yuzukq/hikyaku/docs/README.md

# hikyaku ドキュメント

| 文書 | 内容 |
|---|---|
| [hardware/parts.md](hardware/parts.md) | 部品表と手持ちの状況 |
| [hardware/pcb.md](hardware/pcb.md) | **PCB 化（回路図・フットプリント・発注前の確認）** |
| [hardware/assembly.md](hardware/assembly.md) | 組み立て（ユニバーサル基板・完成形の配線） |
| [hardware/wiring.md](hardware/wiring.md) | 配線（S3 SuperMini のピン配置・ピン割り当て・書き換え手順） |
| [hardware/power.md](hardware/power.md) | 電源（CH9102F から給電・モバイルバッテリー。不要になった Type-C DIP 化キットの記録） |
| [hardware/usb-serial-ch9102f.md](hardware/usb-serial-ch9102f.md) | USB-シリアル変換（ログ用）の使い方 |
| [hardware/trackpad-tm035035.md](hardware/trackpad-tm035035.md) | トラックパッド TM035035 の仕様メモ |
| [keyboard-7skb.md](keyboard-7skb.md) | 対象キーボード 7skb の USB/HID 構成 |
| [ota.md](ota.md) | OTA（BLE 経由のファーム更新）の使い方と仕組み |
| [handoff.md](handoff.md) | 引き継ぎメモ（現状・作業のルール・やってほしいこと） |
| [firmware.md](firmware.md) | ファームウェアの構成・ビルド・書き込み・デバッグ・落とし穴 |
| [design/multi-host.md](design/multi-host.md) | 2 台のマシン（Mac・Windows）の切り替えと、Windows アプリの技術選定 |
| [../win/README.md](../win/README.md) | Windows アプリ（C# / WPF）のビルドと試し方 |
| [design/ring.md](design/ring.md) | ショートカットリング（Mac アプリ `mac/HikyakuRing`）の仕様と使い方 |
| [reference/datasheets.md](reference/datasheets.md) | データシート等へのリンクと保管場所 |

進捗と今後の計画は [../ROADMAP.md](../ROADMAP.md)、全体像は [../README.md](../README.md)。
