yuzukq/hikyaku/tools/traces/README.md

# 実機ログ（トラックパッド）

CH9102F 経由（`tools/hk log`）または S3 の USB-C から直接（`tools/hk usb-log`）取った S3 のログ。色コードと、接続相手のアドレス行は取り除いてある。

| ファイル | 中身 | 注意 |
|---|---|---|
| `2026-10-13-relative-all.log` | 相対モード（`trackpad-trace`）の一晩分。`rel <ms> raw=[b0, b1, b2] dx= dy=` が 1 パケット 1 行。`selftest mode=...` の読み戻しテストの結果も含む | **ほとんどがメス-メスのジャンパー線で接触が不安定だった時期のもの。** `raw=[fc, fc, fc]`（dx=-4 dy=-4）は配線が外れているときのゴミ。`firmware id=0xfc` や `0x00` で始まった起動の区間は信用しない。正常に起動した区間（`firmware id=0x07`、末尾）は、ほぼ動きがない |
| `2026-10-13-absolute-sweep.log` | 旧方式（絶対座標）の `tp <ms> <x> <y> <z> khz=<SPI周波数> raw=[...]`。SPI の周波数を切り替えながら取ったもの | 1MHz 以下では上位ビットが化ける（2MHz 以上が正しい）。これを読むコード（`examples/replay.rs`）は削除済み。タグ `absolute-mode-last` に残っている |
| `2026-10-15-board-sens2x.log` | 基板化後・感度 2X で円を約 20 秒描いたもの（`usb-log` で取得）。1,041 パケット、取りこぼし 0 | 正常な状態のログ。左右・上下とも出ている |

起動の区切りは `ESP-ROM` / `rst:0x` の行。区間ごとの内訳（正常なパケット / `fc` のゴミ）は次のコマンドで出せる。

```sh
awk '/ESP-ROM|rst:0x/{b++} /rel [0-9]+ raw=/{ if ($0 ~ /fc, fc, fc/) fc[b]++; else ok[b]++ }
     END { for (i in ok) print "boot", i, "ok", ok[i], "fc", fc[i] }' tools/traces/2026-10-13-relative-all.log
```

## ホストで再生する

相対モードの変換（軸の入れ替え・反転・倍率・持ち越し・レポートの分割）は `crates/hikyaku-pointer/src/relative.rs` にあり、
ファームと同じ処理をホストで再生できる。

```sh
# 1 パケットごとに出るマウスレポートと集計を見る（quiet=1 で集計だけ。skip_fc=1 で配線不良のゴミを読み飛ばす）
cargo run -q -p hikyaku-pointer --example replay_rel -- tools/traces/2026-10-13-relative-all.log quiet=1 skip_fc=1
# 設定を変えて試す（既定はファームの値: gain=2 swap=1 invx=1 invy=1 scroll_div=8）
cargo run -q -p hikyaku-pointer --example replay_rel -- tools/traces/2026-10-13-relative-all.log gain=1
```

`cargo test -p hikyaku-pointer` は、このログ全体と乱数のパケットで、切り出した処理がファームの元のコード（テスト内の `Golden`）と
1 ビットも違わない出力を出すことを確かめる。
