yuzukq/hikyaku/docs/hardware/trackpad-tm035035.md

# トラックパッド TM035035（Cirque GlidePoint 円形）

出典: *TM035035 Trackpad Specification* Document Version 1.2（2017-11）。
**この仕様書は Cirque の機密表記つきでリポジトリに入れていない**（保管場所は [../reference/datasheets.md](../reference/datasheets.md)）。以下は要点のメモ。

## 型番

| 種別 | 型番 |
|---|---|
| I²C | TM035035-2023-xxx |
| **SPI（手元はこちら）** | TM035035-2024-xxx（x は末尾でオーバーレイの種類: 000 なし / 001 粘着 / 002 フラット / 003 曲面） |

SPI/I²C の切り替えは基板上の **R1**：470kΩ 実装 = SPI、未実装 = I²C。

## 電気的仕様

| 項目 | 値 |
|---|---|
| 電源 | 2.5〜3.6V（3.3V で試験） |
| 消費電流 | 動作時 2.9mA / アイドル 1.7mA / スリープ 40µA（設定要）/ シャットダウン 0.23µA（設定要） |
| ロジックレベル | 3.3V（**GPIO は 5V 耐性なし**） |
| ASIC | Cirque Pinnacle (1CA027) |

## J1 コネクタ（12 ピン FFC, SPI）

Molex 78127-1128 相当（12 回路, 0.5mm ピッチ, 縦型, **非 ZIF**, リバースフットプリント）。
FFC は「**導体が見える面を 1 ピン側**にして挿す」。

| 1 | 2 | 3 | 4 | 5 | 6 | 7 | 8 | 9 | 10 | 11 | 12 |
|---|---|---|---|---|---|---|---|---|---|---|---|
| SCK | MISO | SS | DR | MOSI | BTN2 | BTN3 | BTN1 | SCL | SDA | GND | VDD 3.3V |

- DR = Data Ready（タッチデータがあるとき出力）。ポーリングでも読める
- BTN1〜3 は物理ボタン入力（使わなければ未接続）
- SCL/SDA は SPI 版では使わない

## 座標

- 最大範囲: X 0〜2048, Y 0〜1536
- 実用範囲（クリップ推奨）: **X 128〜1920, Y 64〜1472**
- 座標系: 原点は左上、X は右が +、Y は下が +。ただし **Y 軸はデフォルトで反転**しており、FeedConfig1 の bit7 で反転できる
- 位置は相対（デルタ）／絶対のどちらでも報告できる。モードは電源投入時にホストが設定する

## 寸法

直径 35mm、センサー有効径 31mm。厚さ: 基板 1.0mm、基板＋オーバーレイ 1.25mm、部品込み 5.40mm。
外周に位置合わせ用の切り欠きが 3 つ。ケースでは下から支える（タップでたわむのを防ぐ）。導電性の素材をベゼルに使わない。
オーバーレイは導電性の素材（金・銀・カーボン等）NG、基板との間に空気層を作らない。

## ソフトウェア側

- **ドライバ:** `crates/hikyaku-pinnacle`。SPI（モード 1、2MHz）の RAP: 書き込み `[0x80|addr, v]`、読み出し `[0xA0|addr, 0xFC, 0xFC, 0xFC…]` で **4 バイト目以降**がデータ（自動インクリメント）。
  相対モードだけを扱う（初期化の手順は下の「実装の方針」）。実機で ID=0x07 / バージョン=0x3A を確認済み。
- **変換:** `crates/hikyaku-pointer` の `relative`（相対モードのパケット → マウスレポート）。
- 絶対座標モード（FeedConfig1=0x03、パケットはレジスタ 0x12〜0x17）で自前に移動量を作る旧方式は 2026-10-13 に削除した（タグ `absolute-mode-last`）。
- 参考実装: QMK `cirque_pinnacle`、https://github.com/2bndy5/CirquePinnacle
- **単一指のみ**（Pinnacle 1CA027 は 1 本指の位置しか報告しないと理解している。要確認）。
  ROADMAP にあった「2 本指スクロール」は難しいので、キー押下中スクロール／縁での円スクロールなどで代替する想定。

## 実装の方針（2026-10-13〜）

ZMK（Zephyr の `drivers/input/input_pinnacle.c`）と Cirque 公式の USB マウスのサンプル
（`cirque-corp/Cirque_Pinnacle_1CA027` の `SPI_FlatOverlay_USBMouse.ino`）に合わせた。

- **相対モード**で、パッドが計算した移動量を **1:1 でそのまま**マウスレポートにする（加速は OS に任せる）。
  丸いパッドを長方形の画面に対応づける絶対座標の方式はやめた。
- 初期化: ソフトリセット → 電源投入時のキャリブレーション完了（SW_CC）を待つ → 感度（ADC 減衰 2X。4X では指の検出が途切れた）→ キャリブレーション
  → `FeedConfig2 = 0x1C`（GlideExtend・スクロール・二次タップ無効。タップ有効）→ `FeedConfig1 = 0x01`（相対 + 有効）→ ZIdle = 0。
  **パッド側の反転ビット（0x40/0x80）は使わない**: 相対モードで Y 反転を入れると Y の移動量がほとんど出なくなった（2026-10-13）。
  向きはファーム側（`SWAP_XY`・`SCREEN_X_INVERT`・`SCREEN_Y_INVERT`）で合わせる。この個体はパッドが 90 度回った向きで付いている。
- パケットは 3 バイト。`dx = b1 (b0 の bit4 が立っていたら -256)`、`dy` も同様（bit5）。タップは `b0` の bit0。
- 向き・反転・XY 入れ替えは `firmware/hikyaku-s3/src/bin/trackpad/mod.rs` の `SWAP_XY`・`SCREEN_*_INVERT`。
- 変換そのもの（向き・倍率・持ち越し・レポートの分割）は `crates/hikyaku-pointer/src/relative.rs`（`Relay`）。ホストで実機ログを
  再生してテストできる（[../../tools/traces/README.md](../../tools/traces/README.md)）。静止中のぶれを抑えるフィルタ（`StillFilter`）と
  自前のタップ判定（`SoftTap`）も同じファイルにあり、ファームでは `trackpad-still-filter` / `trackpad-soft-tap` feature で有効にする
  （既定は無効。[../firmware.md](../firmware.md) の feature 一覧）。

- **SPI のクロックは 2MHz 以上にすること。** 250kHz〜1MHz だと、パッドから読む値の MSB が取り違えられる（レジスタの読み戻しテストで約半分が誤り。`0xFF`→`0x7F`、`0x5A`→`0xDA` など）。2MHz・4MHz は 0 エラー（2026-10-13）。
  これを知らずに低いクロックで動かしたため、座標が飛ぶ・片寄るなど、長い間うまく動かなかった。QMK の既定クロックは数 MHz〜10MHz。
- 初期化は QMK と同じ手順（リセット → ADC 減衰 → キャリブレーション）を踏む。起動中（約 1 秒）はパッドに触れない。

- 2026-10-11: ESP32-S3 に SPI で接続（GPIO12=SCK / 13=MISO / 11=MOSI / 10=SS / 9=DR, 3V3, GND。モード 1, 1MHz）。起動ログ `trackpad: firmware id=0x07 version=0x3a` を確認。
  ドライバの SPI コマンド形式（読み出しは 4 バイト目からデータ）が合っていた。
- 接続は FFC 12P ケーブル + 変換基板（ブレッドボード）。

## 実機で確認・調整すること

- Y 軸の向き（`Config::invert_y`）
- ゲイン・加速・平滑化・タップ判定の閾値の体感調整

## 未決

- 実際に使う接続手段（FFC ケーブル + 変換基板か、パッドへの直接はんだ付けか）
- タップ／ドラッグ／スクロールの仕様
