yuzukq/hikyaku/ROADMAP.md

# ROADMAP

詳しい資料は [docs/](docs/README.md) を参照。

## Phase 0: 部品調達

- [x] ESP32-S3 ボード（C3 は USB ホスト不可と判明し、S3 を再調達。2026-10-08 到着。**XIAO ではなく GPIO 番号印字のボード**。ESP32-S3FH4R2 搭載）
- [x] Cirque TM035035（SPI 版 `-2024`）
- [x] USB-C ⇔ USB-C ケーブル（CC の問題なく動作確認済み）
- [x] 秋月 AE-CH9102F-TYPEC-BO（USB-シリアル変換）… ホスト動作中のログ確認用
- [x] 秋月 AE-USB2.0-TYPE-C-5077CR（Type-C DIP 化キット）… 電源用。**CC に 5.1kΩ ×2 が必要**（[docs/hardware/power.md](docs/hardware/power.md)）
- [x] モバイルバッテリー（Type-C 出力の小型品）、ブレッドボード、ジャンパ類
- [x] 開発用の給電・ログを CH9102F に切り替え（C3 は不要に。2026-10-09 確認）
- [x] ~~5.1kΩ ×2~~（CH9102F から給電することにしたので不要）
- [x] トラックパッド用の FFC ケーブル 12P 0.5mm + 変換基板

## Phase 1: USB ホストでキーボードを読む ✅

- [x] 開発環境: **Rust（esp-hal + esp-rtos + embassy + trouble）**
- [x] S3 の 5V ピンから給電し、C-C ケーブルでキーボード（7skb）を接続
- [x] USB ホストでキーボードを認識してブートプロトコル入力を読む

## Phase 2: BLE HID キーボードとして Mac につなぐ ✅

- [x] 固定記述子（キーボード / マウス / コンシューマ）の BLE HID
- [x] Linux (BlueZ) と Mac でペアリング・入力を確認
- [x] ボンディング情報をフラッシュに保存（再起動後も自動再接続）

## Phase 3: パススルー（MVP） ✅

- [x] S3 単独で USB キーボード → BLE → Mac を中継（通常キー、同時押し、Mac のショートカット）
- [ ] 遅延・取りこぼしの体感確認（今のところ問題の報告なし）

## Phase 4: トラックパッド統合 ✅（v1、2026-10-15）

- [x] FFC 12P ケーブル + 変換基板でブレッドボードに引き込み（[docs/hardware/trackpad-tm035035.md](docs/hardware/trackpad-tm035035.md)）
- [x] Pinnacle の SPI ドライバ `crates/hikyaku-pinnacle`（SPI モックで単体テスト済み。実機で動作）
- [x] S3 ファームへ組み込み（`--features trackpad`）
- [x] 実機で疎通確認（2026-10-11）: SPI モード 1 / 1MHz、`trackpad: firmware id=0x07 version=0x3a`（参考実装の値と一致）
- [x] **相対モード**に一本化（絶対座標の方式は削除。タグ `absolute-mode-last`）。SPI は 2MHz（1MHz 以下は MSB が化ける）
- [x] 相対モードの変換をホストでテストできる形に切り出し、実機ログを再生できるようにした（2026-10-13 夜、クラウド。`crates/hikyaku-pointer/src/relative.rs`。PR #1）
- [x] 向き（90° 回転を XY 入れ替え + 反転で補正）・速度（`REL_GAIN = 2`。2026-10-22 に 1.8 倍へ少し遅くした）を実機で調整
- [x] タッチ感度を **2X** に（4X では指の検出が途切れた。2026-10-15。動き・タップとも良好）
- [x] 状態表示: オンボードの RGB LED（GPIO48）で 赤 = キャリブレーション中（触らない）/ 緑・青 = 準備完了（送り先 1・2）/ 赤の点滅 = パッドが見つからない
- [ ] （任意）静止中のぶれを抑えるフィルタ `trackpad-still-filter`、自前のタップ判定 `trackpad-soft-tap` を実機で試す（既定は無効。今のところ不要）
- [x] **スクロール**（2026-10-20）: キーボードの **F24 を押している間**、パッドの上下の動きを縦スクロールにする（F24 は Mac に送らない）。7sPro では親指キーの長押し（QMK のモッドタップ）に F24 を割り当てる。
  向きは持ち主の Mac に合わせて反転（`SCROLL_INVERT`）。速さはパッドの移動量 18 で 1 目盛り（2026-10-22 に 8 → 10 → 12 → 14 → 16 → 18 と減らした）。カーソルは 1.8 倍。**どちらも良好で、これを既定とする（2026-10-22）。**
  2 本指スクロールは不可と判断: 2 本指で触っても、パッドは 1 本の指の動きとして報告し、2 本指を示すビットがない（実機ログで確認。2 本指タップもタップにならない）。
- [x] **本体のボタン**（2026-10-22、実機で確認済み）: GPIO6 と GND の間に MX スイッチを 1 個。
  単押し = 右クリック（ダブルタップを待つので約 250ms 遅れる）、押している間 = スクロール（押したまま動かしたらクリックしない）、
  ダブルタップ = リングの開閉（F23 と同じ）。リング中（ノブ操作を含む）は 1 回押しで閉じる（2026-10-22 実機で確認）。キーボードなしでも使えるように。判定は `crates/hikyaku-pointer/src/button.rs`
- [ ] （任意）横スクロール（スクロール中の左右の動きを AC Pan に）、なめらかなスクロール（HID の Resolution Multiplier。Mac の対応を要確認）、縁をなぞる円スクロール（絶対座標が要る。Phase 9 と合わせて検討）
- [x] 別のキーボード（KBDfans TOFU60 / Og60、`4b42:6071`）（2026-10-23 解決。ほぼ全キーで確認。普段用のファーム e280c55 でも確認）: 原因は 2 つ。
  (1) ライブラリの `KbdHandler::try_register` が構成記述子を読み直すところで TOFU60 が返事をしなくなり、登録が終わらなかった →
  認識のときに読んだ構成記述子を使う自前の `open_keyboard` に置き換え、制御転送に時間切れを付けた。
  (2) バスリセットの直後に問い合わせると応答しない → リセット後 100ms 待つ。失敗したら挿し直しを待たずにバスリセットで 3 回までやり直す

## Phase 5: HID の拡充

- [x] メディアキー（音量・輝度など）とマウスの転送（7skb の IF2 → BLE の ID2/ID3）
- [ ] システムコントロール（電源/スリープ）の転送
- [ ] NKRO キーボード対応（7skb は 6KRO で足りている）
- [ ] キーリマップやレイヤー（特定キー押下中はトラックパッドがスクロール、など）

## Phase 6: 電源

- [x] 方針: モバイルバッテリー → **CH9102F の USB-C**（CC 抵抗あり）→ +5V → S3 の 5V ピン（2026-10-13 変更。Type-C DIP 化キットは不要に）
- [x] CH9102F（PC につないだもの）からの給電で、S3・キーボード・トラックパッドが動くことを確認（2026-10-15、基板）
- [x] モバイルバッテリーから 5V が出て、同じように動くことを確認（2026-10-15）
- [ ] 自動オフしないかを実機で確認（S3 + BLE + キーボードで 100mA 前後）
- [ ] スリープ／復帰と実測の電池持ち

## Phase 6.5: 基板化

配線の完成形: [docs/hardware/assembly.md](docs/hardware/assembly.md)

- [x] ピンソケットを調達
- [x] ユニバーサル基板にはんだ付け（SPI は短く、GND 共通。5V の書き込み用ジャンパーは付けず直結にした。書き込み時は CH9102F の USB を抜く）
- [~] 通電前の短絡・導通の確認: テスターがないため、ファームの診断（`trackpad-probe`）で代用。**変換基板がソケットに 180° 逆に挿さっていた**のを見つけて直した（[docs/hardware/assembly.md](docs/hardware/assembly.md)）。テスターは調達したい
- [x] 読み戻しテスト（`selftest`）が 2MHz で 0 エラーになることを確認（2026-10-15）
- [x] CH9102F の受信（RxD）が効かない（ピンソケットを外すときのコテの熱で壊れた可能性）→ 新品に交換して解決（2026-10-21。普段の構成で `tools/hk log` が読める）
- [~] PCB 化: 手配線の取り違え・短絡・接触不良が多かったので、S3・CH9102F・FFC 変換基板をピンソケットで受け、MX スイッチ 2 個（直付け）を載せた基板を作る（[docs/hardware/pcb.md](docs/hardware/pcb.md)）
  - [x] 回路図とフットプリントの割り当て（2026-10-23。持ち主がレビュー中）
  - [ ] レイアウト（持ち主。ケースの設計と合わせる）
  - [ ] 1:1 で印刷して実物のモジュールと合わせる → DRC → ガーバー → 発注
  - [ ] 2 個目のスイッチ（GPIO7）をファームで読む

## Phase 7: 開発体験・筐体

- [~] OTA（BLE 経由のファーム更新）を実装（[docs/ota.md](docs/ota.md)）。**実機では未成立**（PC の接続・購読まで進んだが、書き込みには至らず。2026-10-12 時点で有線書き込みに戻した）。再挑戦するときは docs/ota.md の「状況」を参照
- [ ] 分割キーボードの間に置けるサイズでケースを設計する
- [~] 専用基板（Phase 6.5 の PCB 化）

## Phase 8: 2 台のマシン（Mac・Windows）の切り替え

設計: [docs/design/multi-host.md](docs/design/multi-host.md)。安定性と電力を重視して、**送り先ごとに別の機器（hikyaku / hikyaku2）として 1 台ずつつなぐ**（2026-10-24 決定）。

- [x] ファーム: 送り先 2 つ（アドレス・名前・ペア情報を分ける）、F21 / F22・ボタンの 3 秒長押し・アプリの命令 `23 p` で切り替え（保存して再起動）、
  送り先ごとのスクロールの向き（`22 v`）、Device Information サービス（PnP ID）、LED の色で送り先（緑 / 青）。Mac・Linux で切り替えと再接続を確認（2026-10-24）
- [x] GitHub Actions で Windows アプリをビルドし、Release「windows-latest」に置く
- [x] Windows でペアリングして、キー・マウス・スクロールが動く（2026-10-24。Dell のラップトップの内蔵 Bluetooth、TP-Link のアダプタのデスクトップ）。
  BARROT のアダプタは Windows がサービス全体を発見しないので使えない。TP-Link のアダプタでは、Windows が MTU の交換を 2 回要求して
  ペアリング・接続が切れたので、trouble-host をリポジトリに置いて対処（`firmware/hikyaku-s3/vendor`）。30 秒ごとの切断は Windows の再起動で消えた。
  ボンドごとの購読（CCCD）をフラッシュに保存（再起動・切り替えの後も、Windows に再ペアリングなしでキーが届く）
- [x] Windows: HID として接続中の hikyaku の独自サービスを開ける（`win/RingProbe`・HikyakuRing の接続を確認。2026-10-24）
- [ ] Windows アプリ（C# / WPF、`win/HikyakuRing`）: リング・ノブ・設定画面・アクション
- [ ] Mac アプリ: 送り先の切り替え・スクロールの向きの設定

- [ ] ボンディングのスロット化、ペアリングモードの名前（hikyaku-BLE1/2）
- [x] 状態表示: 準備ができたときの LED の色で送り先を示す（1 台目 = 緑、2 台目 = 青。2026-10-24）
- [ ] トラックパッドのマウスレポートも同じ宛先へ送る
- [ ] Windows での接続確認（Device Information サービスの要否）

## Phase 9: ショートカットリング（Mac アプリ）（仕様決定 2026-10-20）

丸いパッドを活かして、Logi Options+ の Actions Ring のような**円形のショートカットリング**を Mac に出す。
**F23 で起動**し、リング中だけパッドを絶対座標モードにして、指の角度で 8 方向の項目を選び、離した位置で実行する。
音量・明るさ・シークは、離すとノブ操作モードに移り、外周を回して調整する（中心のタップで抜ける）。Mac 側は Swift / SwiftUI のネイティブアプリ。

仕様: [docs/design/ring.md](docs/design/ring.md)

- [x] ファーム: F23 の検出、リングモード（相対 ↔ 絶対座標の切り替え）、独自の BLE サービスで指の角度・距離・接触を notify（2026-10-21。円の中心・半径・向きは実測で合わせた）
- [x] ファーム: アプリからキーの組み合わせ・メディアキーを送る命令（アクセシビリティの許可が不要）
- [x] Linux: Python（bleak）の簡易クライアントでファーム側を確かめる（`tools/ring/ring.sh`）
- [x] Mac: HID として接続中の hikyaku の独自サービスを、アプリから購読できるかの試作（`mac/RingProbe`。**できた**）
- [x] Mac: リングの UI、選択と実行、ノブモード（`mac/HikyakuRing`。2026-10-21）
- [x] Mac: 設定画面、アクション（音量・明るさ・シーク・任意のキーの組み合わせ）
- [x] Mac: 実機で全機能を確認（2026-10-21。7sPro なしでは ⌃⌥R / `hikyaku-ring://open` で開ける）
- [x] **本体の置き方**（2026-10-23。実機で確認済み: 向きの選択・カーソル・スクロール・リングの 8 方向・電源を入れ直しても保持・基準に戻す）: 0° / 90° / 180° / 270°（時計回り）。ファームがカーソル・スクロール・リングの角度を回し、フラッシュに保存。
  Mac アプリの設定画面に「本体の向き」タブ（本体の絵を 4 つの向きで選ぶ）、リングの項目に「設定画面を開く」（標準の割り当てでは左上。Spotlight と入れ替え）。命令 `20 q` / `21`、イベント 4
- [~] Mac: フルスクリーンのアプリの上にもリングを出す（issue #3。2026-10-28 実装、実機で未確認）。リングが見えないまま離した項目は実行しない
- [~] Mac・Windows: リングから設定画面を開いたとき、ほかのアプリの裏にあっても前に出す（issue #2。2026-10-28 実装、実機で未確認）

## 未決事項

- ~~トラックパッドの接続手段~~ → FFC + 変換基板に決定
- ~~スクロール操作の仕様~~ → F24 / 本体のボタンを押している間スクロール（2 本指は不可。Phase 4）
- 複数キーボードやハブ経由の接続に対応するか
- 書き換え手順の改善方法
