yuzukq/hikyaku/docs/reference/datasheets.md

# データシート・参考資料

## 手元に保管しているもの（リポジトリには入れない）

| 資料 | 場所 | 備考 |
|---|---|---|
| TM035035 Trackpad Specification v1.2 (Cirque, 2017-11) | `~/Downloads/TM035035_SPI-I2C-PINNTrackpad_SPEC1-2.pdf` | **Cirque の機密表記あり（複製・開示禁止）。リポジトリにコピーしない**。要点は [trackpad-tm035035.md](../hardware/trackpad-tm035035.md) に自分の言葉でまとめた |

## 公開資料（リンクのみ）

| 資料 | URL |
|---|---|
| 秋月 AE-USB2.0-TYPE-C-5077CR 回路図 | https://akizukidenshi.com/goodsaffix/AE-USB2.0-TYPE-C-5077CR_schematic.pdf |
| 秋月 Type-C DIP 化キット共通資料（電源用途・CC 抵抗） | https://akizukidenshi.com/goodsaffix/powered_by_type-c.pdf |
| 秋月 AE-CH9102F-TYPEC-BO 説明書 (Ver.2024-07-30) | https://akizukidenshi.com/goodsaffix/AE-CH9102F-TYPEC-BO_20240730-web.pdf |
| 秋月 AE-CH9102F-TYPEC-BO 商品ページ | https://akizukidenshi.com/catalog/g/g129505/ |
| esp-hal (Rust) | https://docs.espressif.com/projects/rust/esp-hal/ |
| trouble (BLE host, Rust) | https://github.com/embassy-rs/trouble |
| embassy-usb-host | https://crates.io/crates/embassy-usb-host |
| Cirque Pinnacle ドライバの実装例 | QMK `cirque_pinnacle` / https://github.com/2bndy5/CirquePinnacle |
