yuzukq/hikyaku/3dData/hikyaku4pcb/preview_inside.png

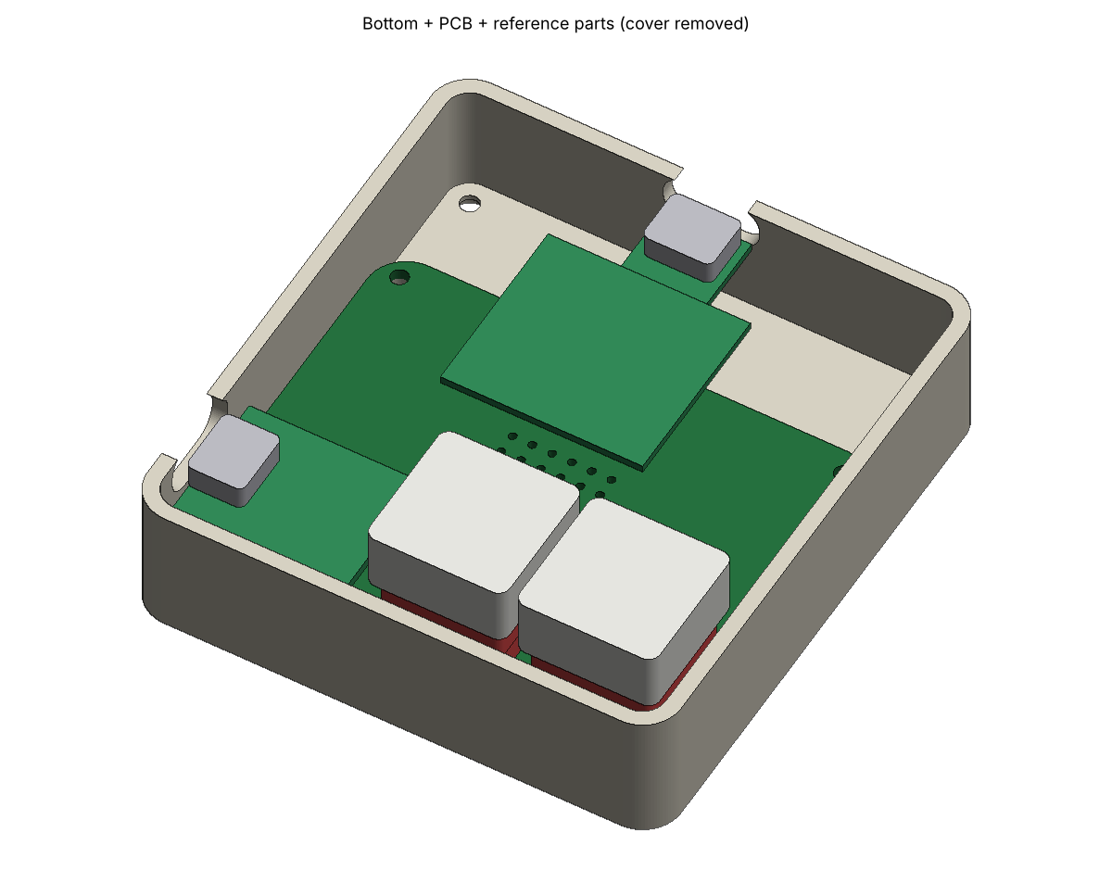
3dData/hikyaku4pcb/preview_inside.png
