yuzukq/hikyaku/3dData/hikyaku4pcb/preview_ring.png

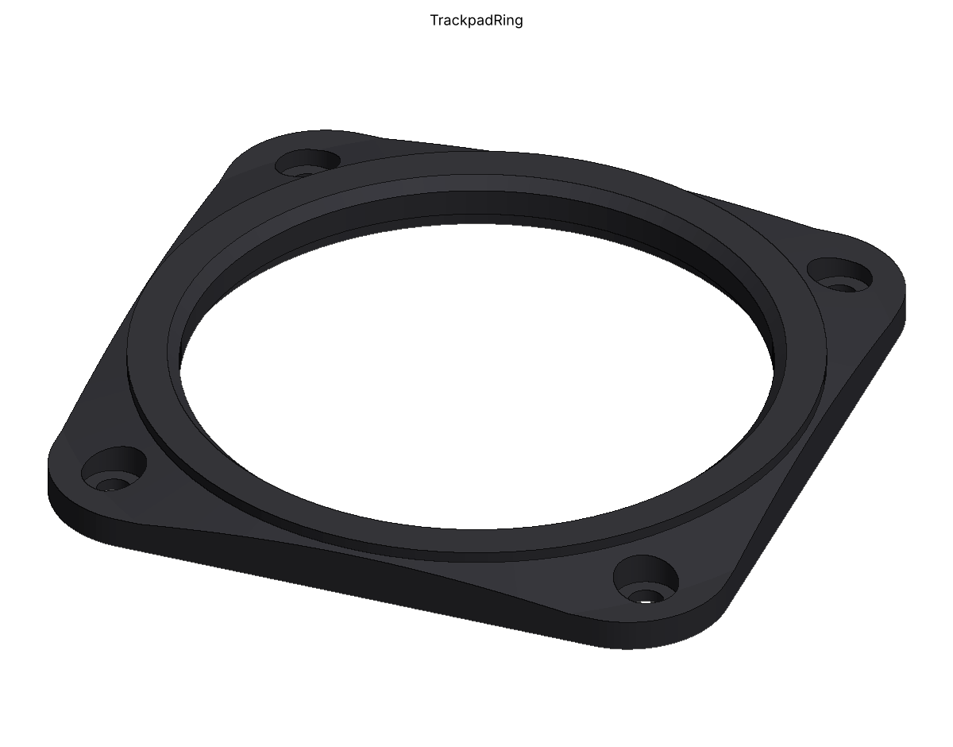
3dData/hikyaku4pcb/preview_ring.png
