yuzukq/hikyaku/docs/hardware/image/s3-supermini-pinout.png

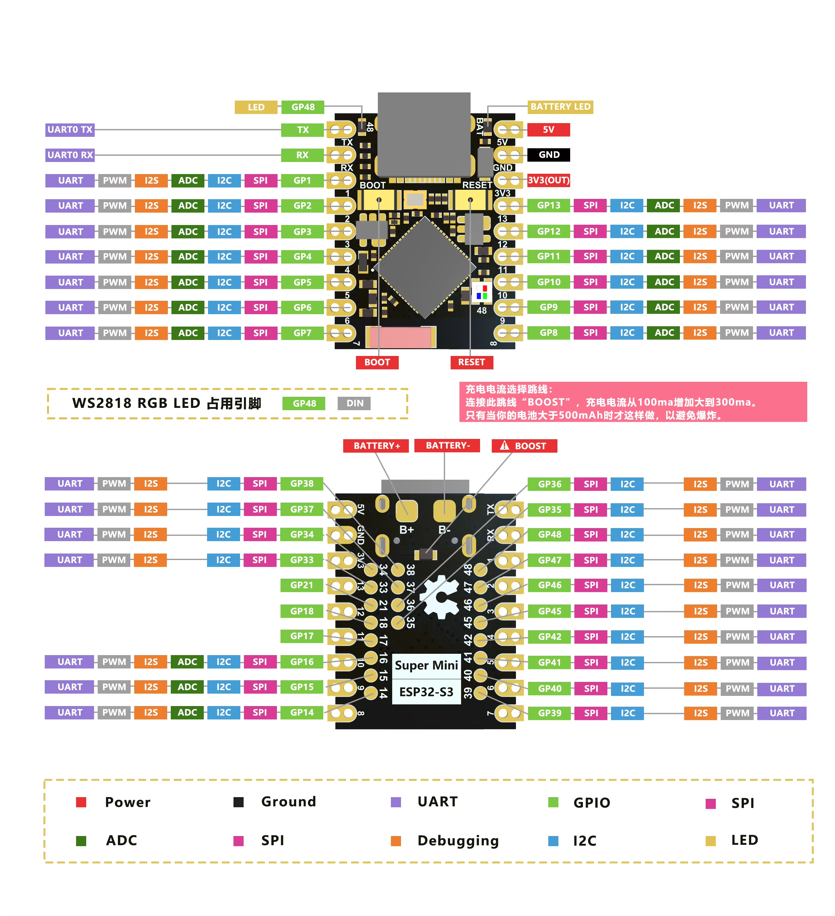
docs/hardware/image/s3-supermini-pinout.png
