yuzukq/hikyaku/docs/hardware/parts.md

# 部品表

2026-10-09 時点（2026-10-23 に PCB 化の部品を追記）。

## 本体

| 部品 | 型番 | 状況 | 用途 |
|---|---|---|---|
| マイコン | **ESP32-S3 SuperMini**（AliExpress。チップは ESP32-S3FH4R2 = 内蔵フラッシュ 4MB + PSRAM 2MB。ピン配置は [wiring.md](wiring.md)） | ✅ 手元（採用） | USB ホスト（キーボードを読む）+ BLE HID |
| トラックパッド | Cirque **TM035035-2024**（SPI 版, Pinnacle） | ✅ 手元 | ポインティング。FFC + 変換基板で接続 |
| キーボード | Salicylic_Acid 7skb（7sPro） | ✅ 手元 | 入力元（USB Type-C） |
| USB-C ⇔ USB-C ケーブル | — | ✅ | S3 とキーボードの接続（CC の問題なく動作確認済み） |
| モバイルバッテリー | Type-C 出力の小型品 | ✅ 手元 | 最終形の電源 |

## 電源まわり

| 部品 | 型番 | 状況 | 備考 |
|---|---|---|---|
| Type-C DIP 化キット | 秋月 AE-USB2.0-TYPE-C-**5077CR** | ✅ 手元（**不要になった**） | CH9102F から給電できるため使わない（[power.md](power.md)） |

## 開発用

| 部品 | 型番 | 状況 | 用途 |
|---|---|---|---|
| USB-シリアル変換 | 秋月 AE-CH9102F-TYPEC-BO | ✅ 手元（2026-10-21 に新品へ交換） | **給電の入口**（バッテリー or PC）+ S3 のログ取得（[usb-serial-ch9102f.md](usb-serial-ch9102f.md)） |
| XIAO ESP32-C3 | — | ✅ 手元（予備） | 初期の BLE 検証に使用。現在は `firmware/uart-bridge-c3`（UART→USB 変換器）が書き込まれたまま。CH9102F があるので不要 |
| ブレッドボード・ジャンパ・ピンヘッダ | — | ✅ | |

## 基板化（2026-10-15 完了）

ブレッドボードのジャンパー線では接触が不安定だったため、ユニバーサル基板にはんだ付けする。配線は [assembly.md](assembly.md)。

| 部品 | 状況 |
|---|---|
| ユニバーサル基板、配線材 | ✅ 手元 |
| ピンソケット（メス）: S3 用 1×9 ×2、CH9102F 用 1×4、FFC 変換基板用 **2×6** | ✅（2026-10-14、基板に実装済み） |
| ピンヘッダ 1×2 + ジャンパーピン（書き込み時に 5V を切る） | 付けなかった（5V は直結。書き込み時は CH9102F の USB を抜く） |
| 0.1µF セラミックコンデンサ（トラックパッドの電源。任意） | 付けなかった（なくても安定して動いている） |

本体のボタン（GPIO6）の MX スイッチも、この基板に付けた（2026-10-22）。

**道具:** 温度調節付きはんだごて、はんだ（0.6〜0.8mm）、フラックス、はんだ吸い取り線、ニッパー、ピンセット、テスター。

## トラックパッド接続

| 部品 | 規格 | 状況 |
|---|---|---|
| FFC フラットケーブル | 12 ピン / 0.5mm ピッチ / 50〜100mm | ✅ 手元 |
| FFC/FPC 変換基板 | 12P 0.5mm → 2.54mm ピッチ、**2×6 のジグザグ**（奇数と偶数で 2 列） | ✅ 手元 |
| （代替）基板裏のパッドに直接はんだ付け | コネクタ不要。小さいパッドなので慎重に | 採用しない（FFC + 変換基板で決定） |

## PCB 化（2026-10-23〜、設計中）

ユニバーサル基板の手配線をやめ、モジュールを挿すだけの基板にする。回路図とフットプリントは [pcb.md](pcb.md)。

| 部品 | 数 | 状況 |
|---|---|---|
| 低背ピンソケット 1×9（S3 用） | 2 | 要確認（Mill-Max 310/315 系など高さ約 3mm のもの。基板を薄くするため） |
| 低背ピンソケット 2×6（FFC 変換基板用） | 1 | 要確認 |
| 低背ピンソケット 2×4（CH9102F 用。CN2 と CN3 をまとめて受ける） | 1 | 要確認 |
| MX スイッチ | 2 | 1 個は使用中。もう 1 個は要確認。基板に直接はんだ付けする（ホットスワップソケットは使わない） |
