yuzukq/hikyaku/3dData/hikyaku4pcb/stl/Cover.stl

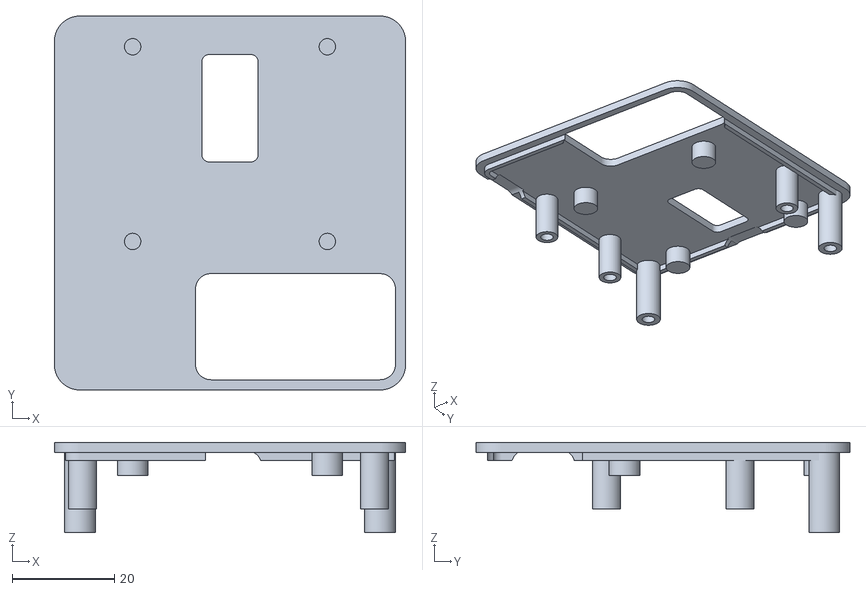
[picture p7: CAD file, 2026-11-05]
3dData/hikyaku4pcb/stl/Cover.stl
68.6 x 73.0 x 17.6
