yuzukq/hikyaku/3dData/Top_new.stl

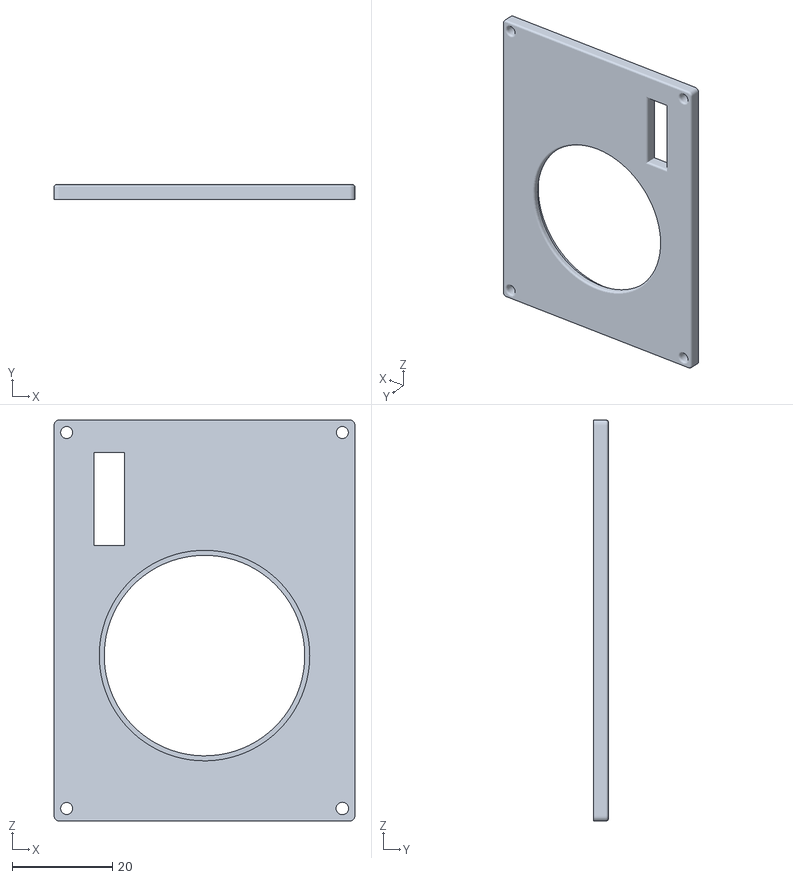
[picture p8: CAD file, 2026-10-20]
3dData/Top_new.stl
60.0 x 3.00 x 80.0
