yuzukq/hikyaku/3dData/hikyaku4pcb/stl/TrackpadRing.stl

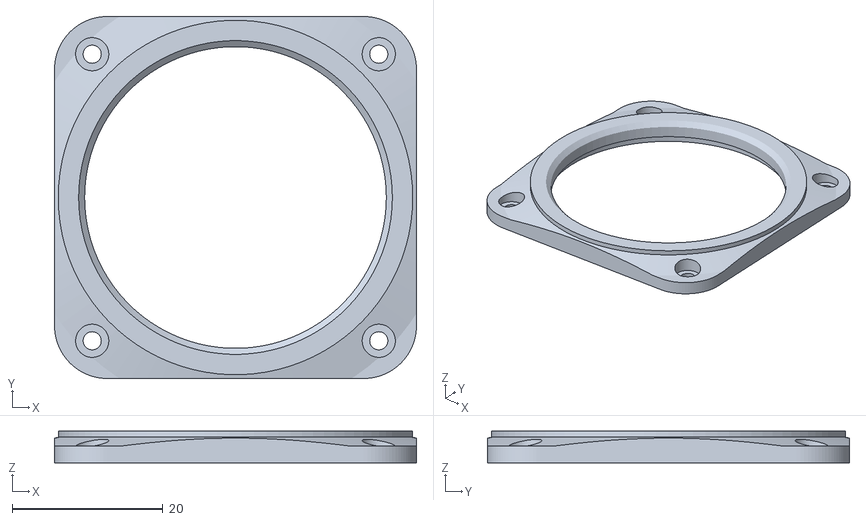
[picture p9: CAD file, 2026-11-05]
3dData/hikyaku4pcb/stl/TrackpadRing.stl
48.0 x 48.0 x 4.20
