yuzukq/hikyaku/3dData/Top.stl

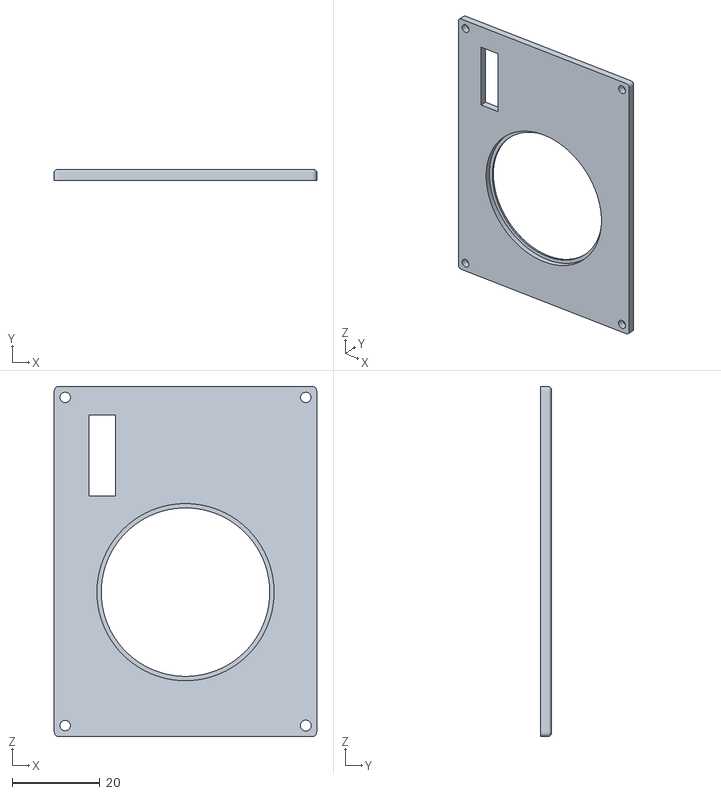
[picture p10: CAD file, 2026-10-18]
3dData/Top.stl
60.0 x 2.50 x 80.0
