yuzukq/hikyaku/3dData/Buttom.stl

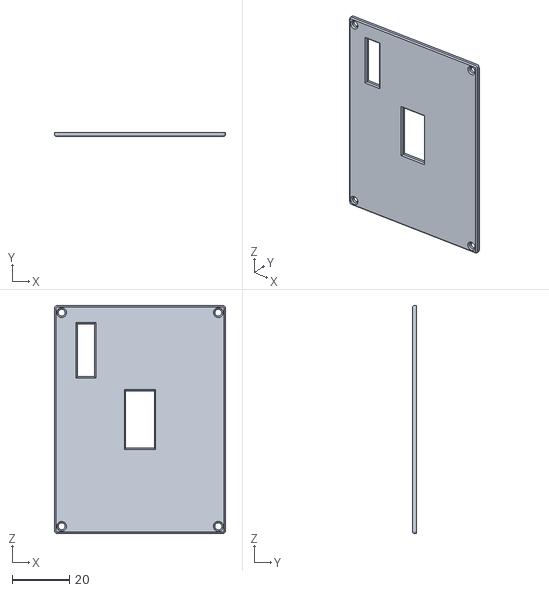
[picture p11: CAD file, 2026-10-18]
3dData/Buttom.stl
60.0 x 1.50 x 80.0
