yuzukq/hikyaku/3dData/hikyaku4pcb/stl/Bottom.stl

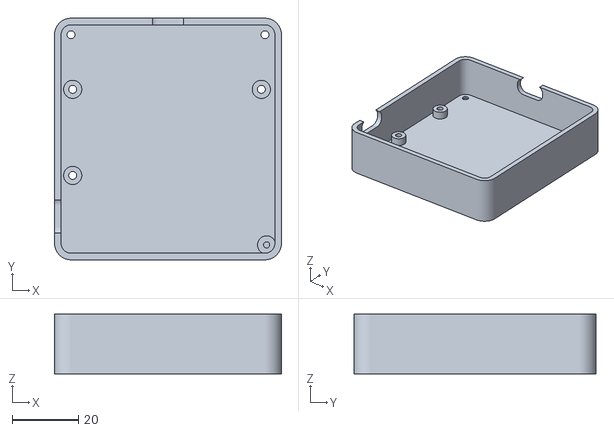
[picture p12: CAD file, 2026-11-05]
3dData/hikyaku4pcb/stl/Bottom.stl
68.6 x 73.0 x 18.1
