yuzukq/hikyaku/(list of files, cad)

Other CAD files:
3dData/hikyaku.f3d
