yuzukq/hikyaku/pcb/hikyaku.kicad_pcb

## KiCad design pcb/hikyaku.kicad_pcb (2026-10-29)

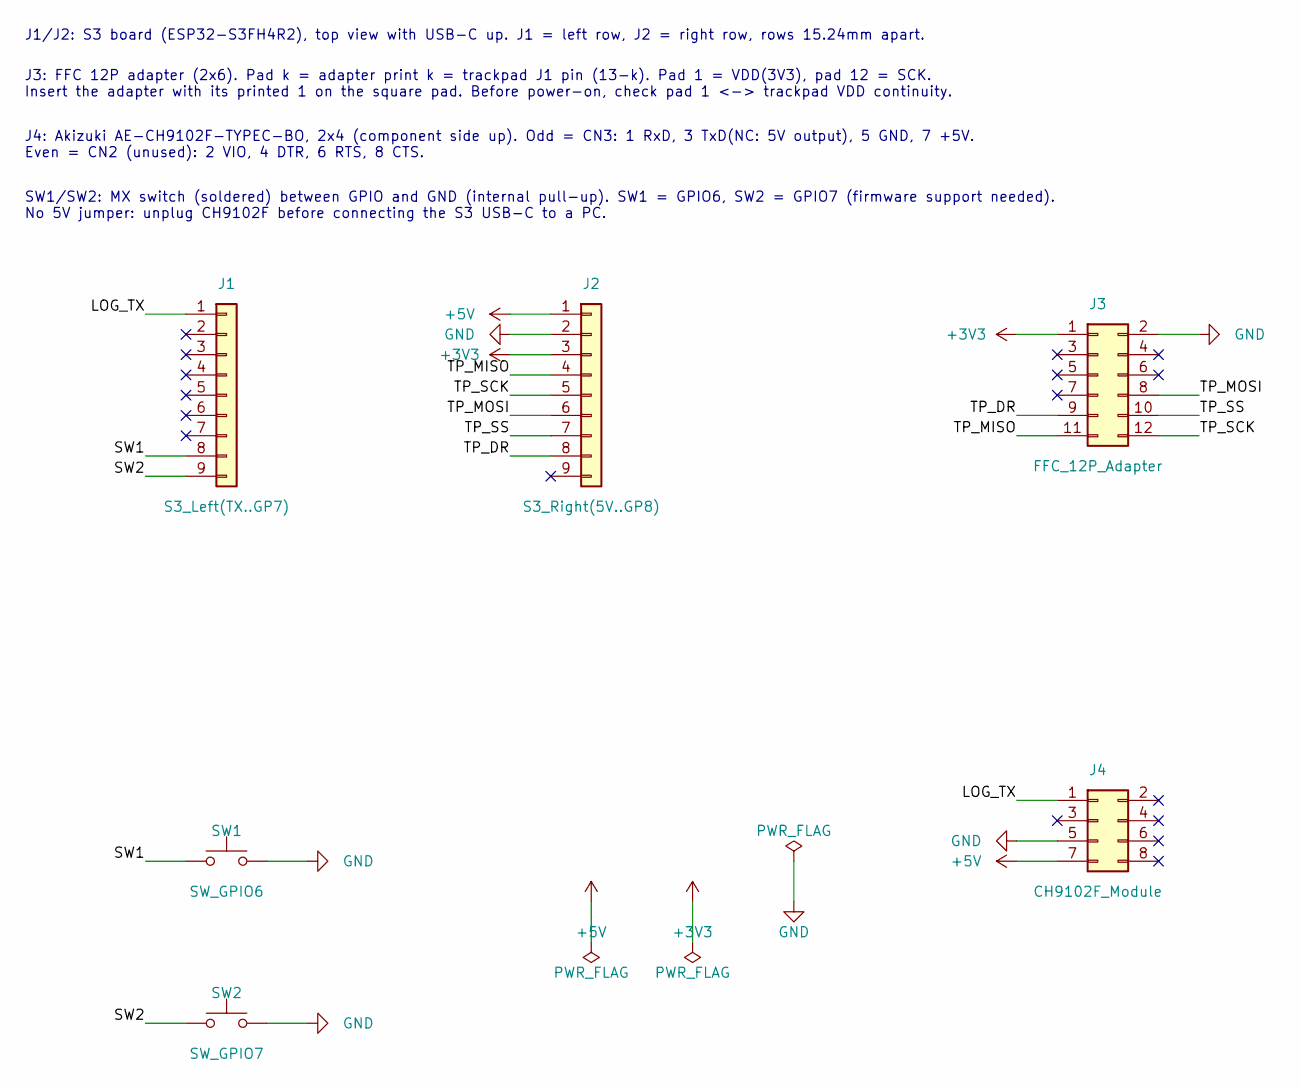
[picture p13: schematic hikyaku.kicad_sch]

Parts:
J1: S3_Left(TX..GP7); PinSocket_1x09_P2.54mm_Vertical
J2: S3_Right(5V..GP8); PinSocket_1x09_P2.54mm_Vertical
J3: FFC_12P_Adapter; PinSocket_2x06_P2.54mm_Vertical
J4: CH9102F_Module; PinSocket_2x04_P2.54mm_Vertical
SW1: SW_GPIO6; CherryMX_Solder_1u
SW2: SW_GPIO7; CherryMX_Solder_1u

Connections:
+3V3: J2.3, J3.1
+5V: J2.1, J4.7
/LOG_TX: J1.1, J4.1
/SW1: J1.8, SW1.1
/SW2: J1.9, SW2.1
/TP_DR: J2.8, J3.9
/TP_MISO: J2.4, J3.11
/TP_MOSI: J2.6, J3.8
/TP_SCK: J2.5, J3.12
/TP_SS: J2.7, J3.10
GND: J2.2, J3.2, J4.5, SW1.2, SW2.2

Notes on the sheet:
J4: Akizuki AE-CH9102F-TYPEC-BO, 2x4 (component side up). Odd = CN3: 1 RxD, 3 TxD(NC: 5V output), 5 GND, 7 +5V. Even = CN2 (unused): 2 VIO, 4 DTR, 6 RTS, 8 CTS.
J1/J2: S3 board (ESP32-S3FH4R2), top view with USB-C up. J1 = left row, J2 = right row, rows 15.24mm apart.
SW1/SW2: MX switch (soldered) between GPIO and GND (internal pull-up). SW1 = GPIO6, SW2 = GPIO7 (firmware support needed). No 5V jumper: unplug CH9102F before connecting the S3 USB-C to a PC.
J3: FFC 12P adapter (2x6). Pad k = adapter print k = trackpad J1 pin (13-k). Pad 1 = VDD(3V3), pad 12 = SCK. Insert the adapter with its printed 1 on the square pad. Before power-on, check pad 1 <-> trackpad VDD continuity.

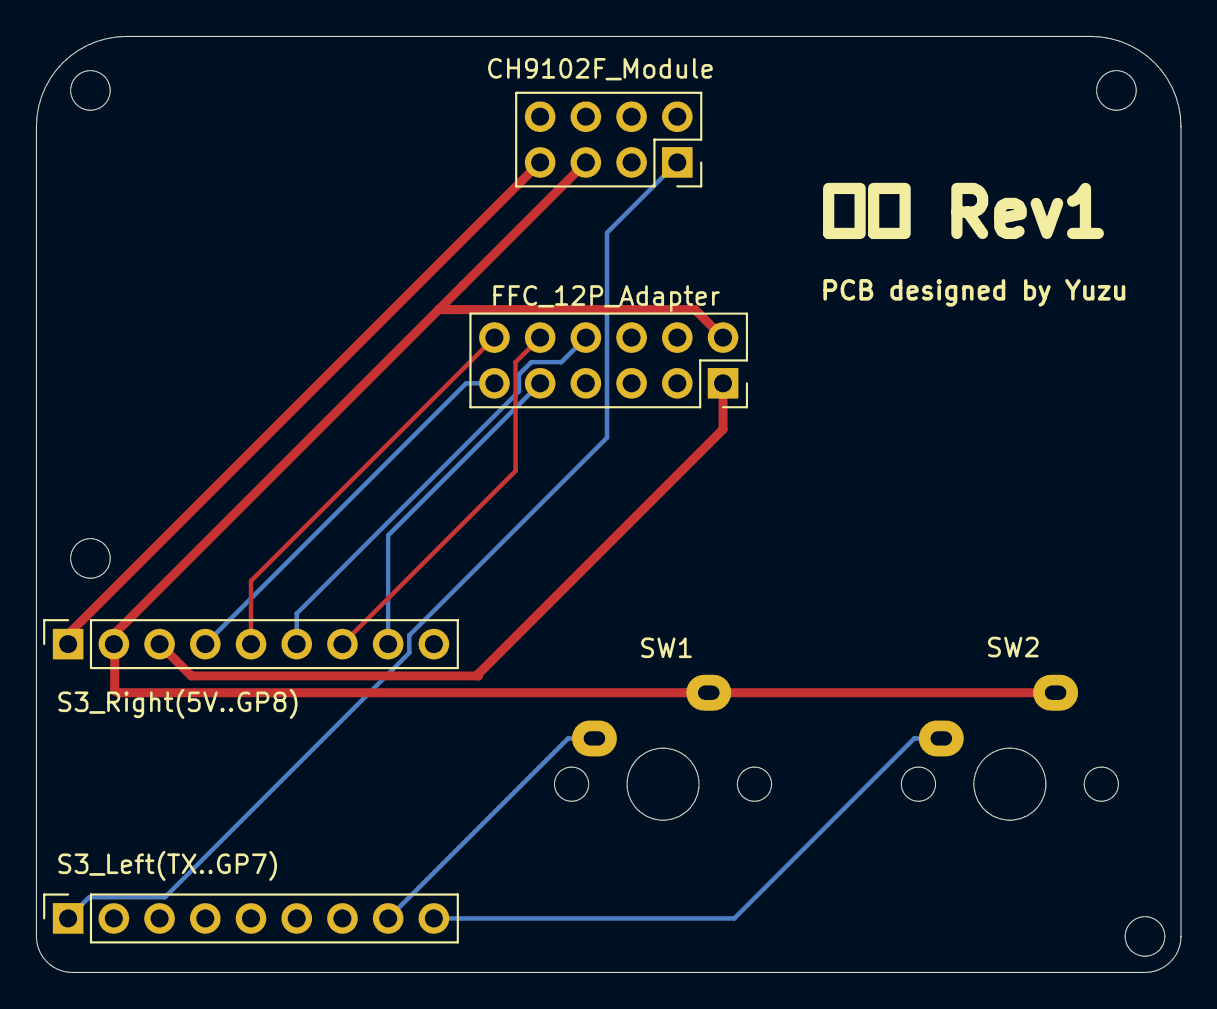
[picture p14: board hikyaku.kicad_pcb from above]

Board: 2 copper layers, 63.6 x 52.0 mm, 6 parts (0 on the bottom side), 11 nets.
