yuzukq/hikyaku/firmware/hikyaku-s3/src/bin/main.rs

#![no_std]
#![no_main]
#![deny(
    clippy::mem_forget,
    reason = "mem::forget is generally not safe to do with esp_hal types, especially those \
    holding buffers for the duration of a data transfer."
)]
#![deny(clippy::large_stack_frames)]

use bt_hci::controller::ExternalController;
use embassy_executor::Spawner;
use embassy_futures::join::join;
use embassy_sync::blocking_mutex::raw::CriticalSectionRawMutex;
use embassy_sync::channel::Channel;
use embassy_sync::signal::Signal;
use embassy_time::{with_timeout, Duration, Timer};
use bond_store::BondStore;
use core::cell::{Cell, RefCell};
use esp_hal::clock::CpuClock;
use esp_storage::FlashStorage;
use esp_hal::timer::timg::TimerGroup;
use esp_hal::usb::otg::{embassy_usb_host::Driver as HostDriver, Usb};

use embassy_futures::select::{select, select3, select4, Either, Either3, Either4};
use embassy_usb_driver::host::{pipe, DeviceEvent, UsbHostAllocator, UsbHostController, UsbPipe};
use embassy_usb_driver::Speed;
use embassy_usb_driver::{EndpointInfo, EndpointType};
use embassy_usb_host::{
    bus,
    control::{ControlPipeExt, SetupPacket},
    descriptor::ConfigurationDescriptor,
    handler::{BusRoute, EnumerationInfo},
    BusState,
};
use esp_radio::ble::controller::BleConnector;
use log::{debug, info, warn};
use trouble_host::prelude::*;

use esp_backtrace as _;

extern crate alloc;

mod bond_store;
mod led;
mod ota;
mod settings;
#[cfg(feature = "trackpad")]
mod trackpad;

const CONNECTIONS_MAX: usize = 1;
const L2CAP_CHANNELS_MAX: usize = 3;
/// 送り先（プロファイル）ごとの名前と BLE アドレス（docs/design/multi-host.md）。送り先ごとに別の機器として見えるので、
/// Mac は hikyaku、Windows は hikyaku2 だけを覚え、別の送り先で待っている間につなぎに来ない。
/// 1 台目は 2026-10 までと同じアドレス（Mac の再ペアリングが要らない）。ランダムの静的アドレスなので、最上位バイトの上 2 ビットは 1。
const PROFILE_NAMES: [&str; settings::PROFILES as usize] = ["hikyaku", "hikyaku2"];
/// 2 台目の IRK（ペアリングで相手に渡す。RPA は使わないので、固定の値でよい）。
const PROFILE2_IRK: u128 = 0x6869_6b79_616b_7532_5f69_726b_5f76_3031;
const PROFILE_ADDRESSES: [[u8; 6]; settings::PROFILES as usize] =
    [[0xff, 0x8f, 0x1a, 0x05, 0xe4, 0xff], [0xfe, 0x8f, 0x1a, 0x05, 0xe4, 0xff]];

esp_bootloader_esp_idf::esp_app_desc!();

/// 固定の HID レポート記述子。接続元キーボードによらずこれ 1 つに詰め替える。
///   ID1: キーボード (mods, reserved, keys[6]) + LED 出力
///   ID2: マウス (buttons, x, y, wheel, pan)
///   ID3: コンシューマ (16bit usage)
#[rustfmt::skip]
const REPORT_MAP: [u8; 149] = [
    // Keyboard
    0x05,0x01, 0x09,0x06, 0xA1,0x01, 0x85,0x01,
    0x05,0x07, 0x19,0xE0, 0x29,0xE7, 0x15,0x00, 0x25,0x01, 0x75,0x01, 0x95,0x08, 0x81,0x02,
    0x95,0x01, 0x75,0x08, 0x81,0x01,
    0x95,0x05, 0x75,0x01, 0x05,0x08, 0x19,0x01, 0x29,0x05, 0x91,0x02,
    0x95,0x01, 0x75,0x03, 0x91,0x01,
    0x95,0x06, 0x75,0x08, 0x15,0x00, 0x26,0xFF,0x00, 0x05,0x07, 0x19,0x00, 0x2A,0xFF,0x00, 0x81,0x00,
    0xC0,
    // Mouse
    0x05,0x01, 0x09,0x02, 0xA1,0x01, 0x85,0x02, 0x09,0x01, 0xA1,0x00,
    0x05,0x09, 0x19,0x01, 0x29,0x08, 0x15,0x00, 0x25,0x01, 0x95,0x08, 0x75,0x01, 0x81,0x02,
    0x05,0x01, 0x09,0x30, 0x09,0x31, 0x09,0x38, 0x15,0x81, 0x25,0x7F, 0x75,0x08, 0x95,0x03, 0x81,0x06,
    0x05,0x0C, 0x0A,0x38,0x02, 0x95,0x01, 0x81,0x06,
    0xC0, 0xC0,
    // Consumer
    0x05,0x0C, 0x09,0x01, 0xA1,0x01, 0x85,0x03, 0x19,0x00, 0x2A,0xA0,0x02, 0x15,0x00, 0x26,0xA0,0x02,
    0x75,0x10, 0x95,0x01, 0x81,0x00, 0xC0,
];

/// BLE へ流す HID レポート。
#[derive(Clone, Copy)]
enum Report {
    Key([u8; 8]),
    Mouse([u8; 5]),
    Consumer([u8; 2]),
    /// ショートカットリングのイベント（独自サービス ring.state へ notify。形式は `hikyaku_pointer::ring::Event`）。
    #[cfg_attr(not(feature = "trackpad"), allow(dead_code))]
    Ring([u8; 12]),
}

static REPORTS: Channel<CriticalSectionRawMutex, Report, 32> = Channel::new();

/// キーボードの組み合わせ（Ctrl+Alt+Shift+Gui+Enter+U）で OTA モードに入る要求。
static OTA_REQUEST: Signal<CriticalSectionRawMutex, ()> = Signal::new();

/// OTA モードで起動するためのフラグ。RTC メモリは再起動をまたいで残る（電源を入れ直すと消える）。
/// OTA の要求を受けたら、これを立てて再起動し、起動直後（BLE の状態が新しいうち）に OTA モードに入る。
const OTA_BOOT_MAGIC: u32 = 0x4F54_4131;
#[esp_hal::ram(unstable(rtc_fast, persistent))]
static mut OTA_BOOT_FLAG: u32 = 0;

/// OTA モードで再起動する。
/// 送り先（プロファイル）を切り替える要求（F21 / F22・本体のボタンの長押し・アプリの命令）。値は切り替え先。
static PROFILE_SWITCH: Signal<CriticalSectionRawMutex, u8> = Signal::new();

/// 送り先を切り替えるための再起動のフラグ（RTC メモリ）。立っていたら、USB の書き換え猶予（3 秒）を飛ばし、LED で送り先を示す。
const SWITCH_BOOT_MAGIC: u32 = 0x5357_4348;
#[esp_hal::ram(unstable(rtc_fast, persistent))]
static mut SWITCH_BOOT_FLAG: u32 = 0;

/// 送り先を保存して再起動する。起動し直すと、その送り先のアドレス・名前・ペア情報でつなぐ。
fn switch_profile_and_reboot(flash: &RefCell<FlashStorage<'_>>, profile: u8) -> ! {
    info!("profile: switching to {} ({})", profile + 1, PROFILE_NAMES[profile as usize]);
    settings::update(flash, |s| s.profile = profile);
    unsafe { core::ptr::addr_of_mut!(SWITCH_BOOT_FLAG).write_volatile(SWITCH_BOOT_MAGIC) };
    esp_hal::system::software_reset()
}

/// 起動時に呼ぶ。送り先の切り替えでの再起動なら true（フラグはここで消す）。
fn take_switch_boot_flag() -> bool {
    let flag = unsafe { core::ptr::addr_of_mut!(SWITCH_BOOT_FLAG) };
    let on = unsafe { flag.read_volatile() } == SWITCH_BOOT_MAGIC;
    unsafe { flag.write_volatile(0) };
    on
}

/// 本体のボタンの長押し: もう一方の送り先へ切り替える。
#[cfg_attr(not(feature = "trackpad"), allow(dead_code))]
fn request_profile_toggle() {
    PROFILE_SWITCH.signal((settings::get().profile + 1) % settings::PROFILES);
}

fn request_ota_reboot() -> ! {
    info!("ota: rebooting into OTA mode");
    unsafe { core::ptr::addr_of_mut!(OTA_BOOT_FLAG).write_volatile(OTA_BOOT_MAGIC) };
    esp_hal::system::software_reset()
}

/// 起動時に呼ぶ。OTA モードでの再起動なら true（フラグはここで消す）。
fn take_ota_boot_flag() -> bool {
    let flag = unsafe { core::ptr::addr_of_mut!(OTA_BOOT_FLAG) };
    let on = unsafe { flag.read_volatile() } == OTA_BOOT_MAGIC;
    unsafe { flag.write_volatile(0) };
    on
}

/// 修飾キーに Ctrl・Shift・Alt・Gui（左右どちらでも）がそろい、Enter(0x28) と U(0x18) が押されている。
fn is_ota_chord(modifiers: u8, keys: &[u8]) -> bool {
    let hyper = modifiers & 0x11 != 0 && modifiers & 0x22 != 0 && modifiers & 0x44 != 0 && modifiers & 0x88 != 0;
    let has = |code: u8| keys.contains(&code);
    hyper && has(0x28) && has(0x18)
}


/// 認識のときに読んだ構成記述子からブートキーボードのインターフェースを探し、割り込み IN パイプを開く。
/// ブートプロトコル（SET_PROTOCOL）と SET_IDLE を、それぞれ時間切れ付きで送る（失敗しても進む。QMK は既定でも同じ 8 バイトを送る）。
///
/// ライブラリの `KbdHandler::try_register` は使わない。構成記述子を読み直すところで、TOFU60（KBDfans Og60）が
/// 返事をしなくなり、登録が終わらなかった（2026-10-23）。
async fn open_keyboard<'d, A: UsbHostAllocator<'d>>(
    alloc: &A,
    info: &EnumerationInfo,
    cfg: &ConfigurationDescriptor<'_>,
) -> Result<A::Pipe<pipe::Interrupt, pipe::In>, &'static str> {
    let iface = cfg
        .iter_interface()
        .find(|i| i.interface_class == 0x03 && i.interface_subclass == 1 && i.interface_protocol == 1)
        .ok_or("no boot keyboard interface")?;
    let ep = iface
        .iter_endpoints()
        .find(|e| e.ep_type() == EndpointType::Interrupt && e.ep_dir() == embassy_usb_driver::Direction::In)
        .ok_or("no interrupt IN endpoint")?;
    let pipe = alloc
        .alloc_pipe::<pipe::Interrupt, pipe::In>(info.device_address, &ep.into(), info.split())
        .map_err(|_| "no pipe")?;
    let mut ctrl = control_pipe(alloc, info).ok_or("no control pipe")?;
    const SET_PROTOCOL: u8 = 0x0B;
    const SET_IDLE: u8 = 0x0A;
    for (name, request) in [("SET_PROTOCOL(boot)", SET_PROTOCOL), ("SET_IDLE", SET_IDLE)] {
        match with_timeout(USB_REQUEST_TIMEOUT, ctrl.class_request_out(request, 0, iface.interface_number as u16, &[])).await {
            Ok(Ok(())) => {}
            Ok(Err(e)) => warn!("usb: {} failed: {:?}", name, e),
            Err(_) => warn!("usb: {} timed out", name),
        }
    }
    Ok(pipe)
}

fn control_pipe<'d, A: UsbHostAllocator<'d>>(alloc: &A, info: &EnumerationInfo) -> Option<A::Pipe<pipe::Control, pipe::InOut>> {
    alloc
        .alloc_pipe::<pipe::Control, pipe::InOut>(
            info.device_address,
            &EndpointInfo {
                addr: 0.into(),
                ep_type: EndpointType::Control,
                max_packet_size: (info.device_desc.max_packet_size0 as u16).min(info.speed().max_packet_size()),
                interval_ms: 0,
            },
            info.split(),
        )
        .ok()
}

/// キーボードの「マウス + コンシューマ（音量など）」インターフェースを探して、
/// その割り込み IN パイプを開く。レポート記述子の先頭が Generic Desktop / Mouse のものを選ぶ
/// （QMK の raw HID など、他の HID インターフェースと区別するため）。構成記述子は認識のときに読んだものを使う。
async fn open_media_pipe<'d, A: UsbHostAllocator<'d>>(
    alloc: &A,
    info: &EnumerationInfo,
    cfg: &ConfigurationDescriptor<'_>,
) -> Option<A::Pipe<pipe::Interrupt, pipe::In>> {
    let mut ctrl = control_pipe(alloc, info)?;
    for iface in cfg.iter_interface() {
        // HID クラスで、ブートキーボード(subclass 1 / protocol 1)以外。
        if iface.interface_class != 0x03 || (iface.interface_subclass == 1 && iface.interface_protocol == 1) {
            continue;
        }
        let desc_len = iface.iter_descriptors().find_map(|(_, d)| {
            (d.len() >= 7 && d[1] == 0x21).then(|| u16::from_le_bytes([d[5], d[6]]))
        })?;
        let mut rd = [0u8; 256];
        let len = (desc_len as usize).min(rd.len());
        let setup = SetupPacket::get_hid_report_descriptor(iface.interface_number, len as u16);
        let n = with_timeout(USB_REQUEST_TIMEOUT, ctrl.control_in(&setup.to_bytes(), &mut rd[..len])).await.ok()?.ok()?;
        if !rd[..n].starts_with(&[0x05, 0x01, 0x09, 0x02]) {
            continue;
        }
        let ep = iface
            .iter_endpoints()
            .find(|e| e.ep_type() == EndpointType::Interrupt && e.ep_dir() == embassy_usb_driver::Direction::In)?;
        info!("usb: media interface {} (report desc {} bytes)", iface.interface_number, n);
        return alloc
            .alloc_pipe::<pipe::Interrupt, pipe::In>(info.device_address, &ep.into(), info.split())
            .ok();
    }
    None
}

/// IF2 のレポート（先頭 1 バイトがレポート ID）を BLE 用のレポートに変換する。
///   ID2: マウス (buttons, x, y, wheel, pan) → そのまま
///   ID4: コンシューマ (usage 16bit)        → こちらの ID3 へ
///   ID3: システムコントロール（電源/スリープ）は BLE 側の記述子に無いので捨てる
fn media_report(buf: &[u8]) -> Option<Report> {
    match (buf.first()?, buf.len()) {
        (2, 6) => Some(Report::Mouse([buf[1], buf[2], buf[3], buf[4], buf[5]])),
        (4, 3) => Some(Report::Consumer([buf[1], buf[2]])),
        _ => None,
    }
}

/// キーボードのレポート（ブート形式 8 バイト）を BLE へ流す。
/// F24 を押している間は、トラックパッドの動きをスクロールにする（F24 自体は Mac に送らない）。
/// 7sPro では、親指キーの長押し（QMK のモッドタップ）に F24 を割り当てている。
#[allow(unused_mut)]
fn forward_key(mut r: [u8; 8]) {
    // F21 / F22: 送り先を 1 台目 / 2 台目に切り替える（ホストには送らない）。今の送り先なら何もしない
    for (key, profile) in [(hikyaku_hid::KEY_F21, 0u8), (hikyaku_hid::KEY_F22, 1u8)] {
        if hikyaku_hid::take_key(&mut r, key) && settings::get().profile != profile {
            PROFILE_SWITCH.signal(profile);
        }
    }
    #[cfg(feature = "trackpad")]
    {
        use core::sync::atomic::{AtomicBool, Ordering};
        let scroll = hikyaku_hid::take_key(&mut r, hikyaku_hid::KEY_F24);
        trackpad::SCROLL_MODE.store(scroll, Ordering::Relaxed);
        // F23 を押した瞬間に、ショートカットリングを開く / 閉じる（F23 は Mac に送らない）。
        static F23_DOWN: AtomicBool = AtomicBool::new(false);
        let f23 = hikyaku_hid::take_key(&mut r, hikyaku_hid::KEY_F23);
        if f23 && !F23_DOWN.swap(true, Ordering::Relaxed) {
            trackpad::RING_CMD.signal(trackpad::RingCmd::Toggle);
        } else if !f23 {
            F23_DOWN.store(false, Ordering::Relaxed);
        }
        // リング中の Esc は、リングを閉じるのに使う（Mac には送らない）。
        if trackpad::RING_ACTIVE.load(Ordering::Relaxed) && hikyaku_hid::take_key(&mut r, hikyaku_hid::KEY_ESC) {
            trackpad::RING_CMD.signal(trackpad::RingCmd::Close);
        }
    }
    let _ = REPORTS.try_send(Report::Key(r));
}

/// `serial-bridge`: PC から USB シリアル/JTAG で届く行（`K<16 桁 hex>` = キーボードの 8 バイト）を、USB キーボードの代わりに使う。
/// PC 側は `hid-probe evbridge`。7sPro が手元にないときの試験用。
#[cfg(feature = "serial-bridge")]
#[embassy_executor::task]
async fn serial_bridge(mut rx: esp_hal::usb::usb_serial_jtag::UsbSerialJtagRx<'static, esp_hal::Async>) {
    let mut line = [0u8; 32];
    let mut len = 0;
    let mut buf = [0u8; 64];
    loop {
        let Ok(n) = embedded_io_async::Read::read(&mut rx, &mut buf).await; // エラーにならない（Infallible）
        for &b in &buf[..n] {
            match b {
                b'\n' | b'\r' => {
                    if len == 17 && line[0] == b'K' {
                        let nib = |c: u8| (c as char).to_digit(16).map(|d| d as u8);
                        let mut r = [0u8; 8];
                        let ok = (0..8).all(|i| match (nib(line[1 + 2 * i]), nib(line[2 + 2 * i])) {
                            (Some(h), Some(l)) => {
                                r[i] = h << 4 | l;
                                true
                            }
                            _ => false,
                        });
                        if ok {
                            forward_key(r);
                        }
                    }
                    len = 0;
                }
                _ if len < line.len() => {
                    line[len] = b;
                    len += 1;
                }
                _ => len = 0,
            }
        }
    }
}

/// USB の認識・キーボードの登録の 1 段階の時間切れ（ライブラリの制御転送には時間切れがない）。
const USB_STEP_TIMEOUT: Duration = Duration::from_secs(3);
/// 失敗したとき、挿し直しを待たずにバスリセットでやり直す回数と、その前に待つ時間。
const USB_RETRIES: u8 = 3;
const USB_RETRY_DELAY: Duration = Duration::from_millis(300);
/// バスリセット（つないだときも含む）の後、問い合わせる前に待つ時間（USB の規格ではリセット後 10ms 以上。
/// TOFU60 は、リセット直後に問い合わせると応答しなかった）。
const USB_RESET_RECOVERY: Duration = Duration::from_millis(100);
/// 制御転送 1 回の時間切れ。
const USB_REQUEST_TIMEOUT: Duration = Duration::from_millis(500);

/// USB ホスト：つながったキーボード（ブートプロトコル）を読んで REPORTS に流す。
#[cfg_attr(feature = "usb-log", allow(dead_code))]
#[embassy_executor::task]
async fn usb_host(usb: Usb<'static>, fast_start: bool) {
    static BUS_STATE: BusState = BusState::new();
    // ホストにすると USB シリアル/JTAG（書き込み用）が使えなくなる。
    // 起動後しばらくは猶予を置き、その間なら espflash で書き換えられるようにする。
    // 送り先の切り替えでの再起動なら、待たない（書き換えるときは電源を入れ直すので、猶予はそこで取れる）。
    if !fast_start {
        Timer::after(Duration::from_secs(3)).await;
    }
    let (mut ctrl, handle) = bus(HostDriver::new(usb), &BUS_STATE);
    let mut cfg = [0u8; 256];
    // 認識・登録に失敗したとき、挿し直しを待たずにバスリセットでやり直す。retry = やり直すときの速度と回数
    let mut retry: Option<(Speed, u8)> = None;

    loop {
        let (speed, tries) = match retry.take() {
            Some(r) => r,
            None => {
                info!("usb: waiting for device");
                (ctrl.wait_for_connection().await, 0)
            }
        };
        Timer::after(USB_RESET_RECOVERY).await;

        let (info, n) = match with_timeout(USB_STEP_TIMEOUT, handle.enumerate(BusRoute::Direct(speed), &mut cfg)).await {
            Ok(Ok(r)) => r,
            failed => {
                match failed {
                    Ok(Err(e)) => warn!("usb: enumerate failed: {:?}", e),
                    _ => warn!("usb: enumerate timed out"),
                }
                if tries < USB_RETRIES {
                    // つないだ直後に応答しないキーボードがある（TOFU60）。少し待ってバスリセットし、やり直す
                    warn!("usb: resetting the bus and retrying ({}/{})", tries + 1, USB_RETRIES);
                    Timer::after(USB_RETRY_DELAY).await;
                    ctrl.controller_mut().bus_reset().await;
                    retry = Some((speed, tries + 1));
                } else {
                    led::set(led::YELLOW); // 診断: USB の認識に失敗
                }
                continue;
            }
        };
        info!(
            "usb: device {:04x}:{:04x} addr={} config {} bytes",
            info.device_desc.vendor_id, info.device_desc.product_id, info.device_address, n
        );
        let Ok(config) = ConfigurationDescriptor::try_from_slice(&cfg[..n.min(cfg.len())]) else {
            warn!("usb: bad configuration descriptor");
            led::set(led::PURPLE);
            handle.free_address(info.device_address);
            continue;
        };

        let mut kbd = match open_keyboard(&handle, &info, &config).await {
            Ok(k) => k,
            Err(e) => {
                warn!("usb: not a boot keyboard: {}", e);
                led::set(led::PURPLE); // 診断: ブートキーボードが見つからない
                handle.free_address(info.device_address);
                continue;
            }
        };
        info!("usb: keyboard ready");
        led::flash(led::WHITE, 300).await; // 診断: キーボードを認識した
        let mut first_key = true;

        let mut media = open_media_pipe(&handle, &info, &config).await;
        if media.is_none() {
            info!("usb: no media interface (volume/mouse keys will not be forwarded)");
        }
        let mut kbuf = [0u8; 8];
        let mut mbuf = [0u8; 16];

        loop {
            let media_in = async {
                match media.as_mut() {
                    Some(pipe) => pipe.request_in(&mut mbuf).await,
                    None => core::future::pending().await,
                }
            };
            match select(select(kbd.request_in(&mut kbuf), media_in), ctrl.wait_for_device_event()).await {
                Either::First(Either::Second(Ok(n))) => {
                    if let Some(r) = media_report(&mbuf[..n]) {
                        let _ = REPORTS.try_send(r);
                    }
                }
                Either::First(Either::Second(Err(e))) => {
                    warn!("usb: media read error: {:?}", e);
                    break;
                }
                // ブートキーボードのレポート: 修飾キー, 予約, キー × 6
                Either::First(Either::First(Ok(n))) if n >= 3 => {
                    let mut r = [0u8; 8];
                    r[..n.min(8)].copy_from_slice(&kbuf[..n.min(8)]);
                    r[1] = 0;
                    #[cfg(feature = "usb-trace")]
                    info!("usb: key report {:02x?}", r);
                    if is_ota_chord(r[0], &r[2..]) {
                        info!("usb: OTA chord");
                        OTA_REQUEST.signal(());
                        let _ = REPORTS.try_send(Report::Key([0; 8])); // 押しっぱなしを残さない。転送はしない
                        continue;
                    }
                    if first_key {
                        first_key = false;
                        led::flash(led::CYAN, 200).await; // 診断: 最初のキー入力が届いた
                    }
                    forward_key(r);
                }
                Either::First(Either::First(Ok(_))) => {}
                Either::First(Either::First(Err(e))) => {
                    warn!("usb: read error: {:?}", e);
                    led::set(led::ORANGE); // 診断: キーボードの読み取りエラー
                    break;
                }
                Either::Second(DeviceEvent::Disconnected) => break,
                Either::Second(_) => {}
            }
        }
        info!("usb: keyboard detached");
        #[cfg(feature = "trackpad")]
        trackpad::SCROLL_MODE.store(false, core::sync::atomic::Ordering::Relaxed);
        handle.free_address(info.device_address);
        // 押しっぱなしが残らないよう全解放を送る。
        let _ = REPORTS.try_send(Report::Key([0; 8]));
        let _ = REPORTS.try_send(Report::Mouse([0; 5]));
        let _ = REPORTS.try_send(Report::Consumer([0; 2]));
    }
}

/// `connections_max` は、購読（CCCD）の状態を覚えておく相手の数。既定の 1 だと、Mac が使った枠のせいで、
/// 別の相手（OTA 用の PC や 2 台目のホスト）が通知を購読できなくなる。
/// `attribute_table_size` は、2 台目の GAP / GATT サービス（`windows_gap_table`）が既定より 1 つ多いので、余裕を持たせる。
#[gatt_server(connections_max = 4, attribute_table_size = 64)]
struct Server {
    hid: HidService,
    battery: BatteryService,
    /// OTA（常に存在するが、OTA モード以外では書き込みを拒否する）。末尾に置いて、既存サービスのハンドルを動かさない。
    ota: OtaService,
    /// ショートカットリング（docs/design/ring.md）。OTA の後ろに足して、既存サービスのハンドルを動かさない。
    ring: RingService,
    /// Device Information（PnP ID）。HID over GATT の仕様で必須で、Windows はこれが無いとつながらないことがある。
    /// 末尾に足して、既存サービスのハンドルを動かさない（Mac の再ペアリングが要らない）。
    device_info: DeviceInfoService,
}

/// PnP ID: ベンダー ID の出所 = Bluetooth SIG（0x01）、会社 = Espressif（0x02E5）、製品 0x0001、版 0x0100。
#[gatt_service(uuid = "180a")]
struct DeviceInfoService {
    #[characteristic(uuid = "2a29", read, value = [b'h', b'i', b'k', b'y', b'a', b'k', b'u'])]
    manufacturer: [u8; 7],
    #[characteristic(uuid = "2a50", read, value = [0x01, 0xE5, 0x02, 0x01, 0x00, 0x00, 0x01])]
    pnp_id: [u8; 7],
}

/// ショートカットリング。state: hikyaku → アプリ（開いた・閉じた・指の位置。12 バイト）、ctrl: アプリ → hikyaku（HELLO・CLOSE・OPEN）。
#[gatt_service(uuid = "6b9a0010-6f1e-4b8e-9d57-7f0d0a5b0001")]
struct RingService {
    #[characteristic(uuid = "6b9a0011-6f1e-4b8e-9d57-7f0d0a5b0001", read, notify, value = [0; 12])]
    state: [u8; 12],
    #[characteristic(uuid = "6b9a0012-6f1e-4b8e-9d57-7f0d0a5b0001", write, write_without_response, value = [0; 8])]
    ctrl: [u8; 8],
}

#[gatt_service(uuid = service::HUMAN_INTERFACE_DEVICE)]
struct HidService {
    #[characteristic(uuid = "2a4a", read, value = [0x11, 0x01, 0x00, 0x02])]
    hid_info: [u8; 4],
    #[characteristic(uuid = "2a4b", read, value = REPORT_MAP)]
    report_map: [u8; 149],
    #[characteristic(uuid = "2a4c", write_without_response)]
    control_point: u8,
    #[characteristic(uuid = "2a4e", read, write_without_response, value = 1)]
    protocol_mode: u8,
    #[descriptor(uuid = "2908", read, value = [0x01, 0x01])]
    #[characteristic(uuid = "2a4d", read, notify, value = [0; 8])]
    keyboard_in: [u8; 8],
    #[descriptor(uuid = "2908", read, value = [0x01, 0x02])]
    #[characteristic(uuid = "2a4d", read, write, write_without_response, value = [0])]
    keyboard_leds: [u8; 1],
    #[descriptor(uuid = "2908", read, value = [0x02, 0x01])]
    #[characteristic(uuid = "2a4d", read, notify, value = [0; 5])]
    mouse_in: [u8; 5],
    #[descriptor(uuid = "2908", read, value = [0x03, 0x01])]
    #[characteristic(uuid = "2a4d", read, notify, value = [0; 2])]
    consumer_in: [u8; 2],
}

#[gatt_service(uuid = "6b9a0001-6f1e-4b8e-9d57-7f0d0a5b0001")]
struct OtaService {
    #[characteristic(uuid = "6b9a0002-6f1e-4b8e-9d57-7f0d0a5b0001", write, notify, value = [0; 80])]
    ctrl: [u8; 80],
    #[characteristic(uuid = "6b9a0003-6f1e-4b8e-9d57-7f0d0a5b0001", write_without_response, value = [0; 244])]
    data: [u8; 244],
}

#[gatt_service(uuid = service::BATTERY)]
struct BatteryService {
    #[characteristic(uuid = characteristic::BATTERY_LEVEL, read, notify, value = 100)]
    level: u8,
}

#[esp_rtos::main]
async fn main(spawner: Spawner) -> ! {
    esp_println::logger::init_logger_from_env();

    let config = esp_hal::Config::default().with_cpu_clock(CpuClock::max());
    #[allow(unused_mut)] // `trackpad-probe` でピンを一時的に借りるため
    let mut peripherals = esp_hal::init(config);

    esp_alloc::heap_allocator!(#[esp_hal::ram(reclaimed)] size: 66320);

    let timg0 = TimerGroup::new(peripherals.TIMG0);
    esp_rtos::start(timg0.timer0, peripherals.FROM_CPU_INTR0);

    // オンボードの RGB LED（GPIO48）。トラックパッドの準備ができるまで赤（触らない）、できたら送り先の色（1 台目 = 緑、2 台目 = 青）、パッドが見つからなければ赤の点滅。
    led::init(peripherals.RMT, peripherals.GPIO48);

    // 設定（置き方・送り先・スクロールの向き）を最初に読む。送り先で BLE のアドレスと名前が決まる。
    let flash = RefCell::new(FlashStorage::new(peripherals.FLASH));
    ota::mark_app_valid(&flash);
    let config = settings::load(&flash);
    let switched = take_switch_boot_flag();
    #[cfg(feature = "trackpad")]
    {
        use core::sync::atomic::Ordering;
        trackpad::ROTATION.store(config.rotation, Ordering::Relaxed);
        trackpad::SCROLL_INVERT.store(config.scroll_invert_now(), Ordering::Relaxed);
    }
    let name = PROFILE_NAMES[config.profile as usize];
    #[cfg(feature = "trackpad")]
    led::set(led::RED);

    #[cfg(feature = "trackpad")]
    {
        use esp_hal::{
            gpio::{Input, InputConfig, Level, Output, OutputConfig, Pull},
            spi::{master::{Config as SpiConfig, Spi}, Mode},
            time::Rate,
        };
        // 診断（`trackpad-probe`）: SPI を使う前に、DR と MISO のピンの状態を読む。テスターがなくても配線の切り分けができる。
        #[cfg(feature = "trackpad-probe")]
        {
            let d = esp_hal::delay::Delay::new();
            // パッドは電源投入後のキャリブレーションが終わると DR を High にする（SPI でフラグを消すまで High のまま）。
            d.delay_millis(300);
            let mut cs = Output::new(peripherals.GPIO10.reborrow(), Level::High, OutputConfig::default());
            let dr = Input::new(peripherals.GPIO9.reborrow(), InputConfig::default().with_pull(Pull::Down)).is_high();
            let mut miso = |pull: Pull| {
                let p = Input::new(peripherals.GPIO13.reborrow(), InputConfig::default().with_pull(pull));
                d.delay_micros(200);
                p.is_high()
            };
            let (hi_up, hi_down) = (miso(Pull::Up), miso(Pull::Down));
            cs.set_low();
            d.delay_micros(50);
            let (lo_up, lo_down) = (miso(Pull::Up), miso(Pull::Down));
            cs.set_high();
            info!(
                "probe: DR={} | MISO with CS high: pull-up={} pull-down={} | MISO with CS low: pull-up={} pull-down={}",
                dr as u8, hi_up as u8, hi_down as u8, lo_up as u8, lo_down as u8
            );
            drop(cs);

            // 短絡の検査: GPIO9〜13 を全部プルダウン（またはプルアップ）の入力にし、1 本ずつ逆のレベルで駆動して、
            // ほかのピンがつられるかを見る。つられたピン同士は短絡している。駆動したピン自身が駆動したレベルにならなければ、
            // GND（または 3V3）と直接つながっている。駆動は数十µs だけ。
            use esp_hal::gpio::Flex;
            let mut pins = [
                Flex::new(peripherals.GPIO9.reborrow()),
                Flex::new(peripherals.GPIO10.reborrow()),
                Flex::new(peripherals.GPIO11.reborrow()),
                Flex::new(peripherals.GPIO12.reborrow()),
                Flex::new(peripherals.GPIO13.reborrow()),
            ];
            const NAMES: [u8; 5] = [9, 10, 11, 12, 13];
            for (pull, drive_high) in [(Pull::Down, true), (Pull::Up, false)] {
                for p in pins.iter_mut() {
                    p.set_output_enable(false);
                    p.apply_input_config(&InputConfig::default().with_pull(pull));
                    p.set_input_enable(true);
                }
                d.delay_micros(200);
                let mut base = [0u8; 5];
                for (b, p) in base.iter_mut().zip(pins.iter()) {
                    *b = p.is_high() as u8;
                }
                info!("probe: pull-{} idle levels GPIO9..13 = {:?}", if drive_high { "down" } else { "up" }, base);
                for i in 0..pins.len() {
                    if drive_high {
                        pins[i].set_high();
                    } else {
                        pins[i].set_low();
                    }
                    pins[i].set_output_enable(true);
                    d.delay_micros(20);
                    let mut got = [0u8; 5];
                    for (g, p) in got.iter_mut().zip(pins.iter()) {
                        *g = p.is_high() as u8;
                    }
                    pins[i].set_output_enable(false);
                    d.delay_micros(50);
                    info!(
                        "probe: pull-{} drive GPIO{} {} -> GPIO9..13 = {:?}",
                        if drive_high { "down" } else { "up" },
                        NAMES[i],
                        if drive_high { "high" } else { "low" },
                        got
                    );
                }
            }
            for p in pins.iter_mut() {
                p.set_output_enable(false);
                p.apply_input_config(&InputConfig::default());
            }
        }
        let spi = Spi::new(
            peripherals.SPI2,
            SpiConfig::default().with_frequency(Rate::from_khz(2000)).with_mode(Mode::_1),
        )
        .unwrap()
        .with_sck(peripherals.GPIO12)
        .with_mosi(peripherals.GPIO11)
        .with_miso(peripherals.GPIO13);
        let cs = Output::new(peripherals.GPIO10, Level::High, OutputConfig::default());
        let dr = Input::new(peripherals.GPIO9, InputConfig::default().with_pull(Pull::Down));
        // 本体のボタン（MX スイッチを GPIO6 と GND の間に。押すと Low）。つないでいなければプルアップで High のまま（何も起きない）。
        let button = Input::new(peripherals.GPIO6, InputConfig::default().with_pull(Pull::Up));
        spawner.spawn(trackpad::run(spi, cs, dr, button).unwrap());
    }

    // `usb-log` のときは USB-C をログ（USB シリアル/JTAG）に使うので、USB ホストは動かさない。
    #[cfg(not(feature = "usb-log"))]
    {
        let usb = Usb::new_fs(peripherals.USB_FS, peripherals.GPIO20, peripherals.GPIO19);
        spawner.spawn(usb_host(usb, switched).unwrap());
    }
    #[cfg(feature = "usb-log")]
    info!("usb-log: logging over the S3 USB-C; USB host (keyboard) is disabled");
    #[cfg(feature = "serial-bridge")]
    {
        let (rx, _tx) = esp_hal::usb::usb_serial_jtag::UsbSerialJtag::new(peripherals.USB_DEVICE).into_async().split();
        spawner.spawn(serial_bridge(rx).unwrap());
        info!("serial-bridge: key reports from the PC (hid-probe evbridge)");
    }

    let transport = BleConnector::new(peripherals.BT, Default::default()).unwrap();
    let controller = ExternalController::<_, 1>::new(transport);
    let mut resources: HostResources<_, DefaultPacketPool, CONNECTIONS_MAX, L2CAP_CHANNELS_MAX> =
        HostResources::new();

    let address = Address::random(PROFILE_ADDRESSES[config.profile as usize]);
    info!("profile {}: advertising as {}", config.profile + 1, name);
    // トラックパッドなしの版: 送り先の色をすぐ出す（ありの版はキャリブレーションの後に trackpad が出す）
    #[cfg(not(feature = "trackpad"))]
    led::set(led::ready(config.profile));
    let mut builder = trouble_host::new(controller, &mut resources)
        .set_random_address(address)
        .set_io_capabilities(IoCapabilities::NoInputNoOutput);
    // 2 台目（Windows）: ペアリングで渡す IRK を、全部ゼロではない固定の値にする。trouble-host は IRK が無いと
    // ゼロの IRK を渡し、Windows はペアリングの後の準備（GATT を読んで HID の機器を作る）をしなかった（2026-10-24）。
    // IRK を持つとアドレスが RPA になるので、広告は固定のランダムアドレスのまま（`advertise_params`）。
    // 1 台目（Mac）は今までどおり（ペア情報を作り直さないため）。
    if config.profile == 1 {
        builder = builder.enable_privacy(IdentityResolvingKey::new(PROFILE2_IRK).unwrap());
    }
    let stack = builder.build();
    let advertise_params = AdvertisementParameters {
        own_addr_kind: (config.profile == 1).then_some(AddrKind::RANDOM),
        ..Default::default()
    };
    // 今の送り先の、保存済みのペア情報を復元する（ホスト側で削除しない限り、再起動後も再ペアリング不要）。
    let store = RefCell::new(BondStore::load(&flash, config.profile));
    for bond in store.borrow().bonds() {
        if let Err(e) = stack.add_bond_information(bond.clone()) {
            warn!("restore bond failed: {:?}", e);
        }
    }
    let mut peripheral = stack.peripheral();
    let mut runner = stack.runner();

    // 1 台目（Mac）は trouble-host の既定の GAP / GATT サービス（ハンドルを動かさない）。2 台目（Windows）は自前（`windows_gap_table`）。
    let (server, service_changed) = if config.profile == 1 {
        let mut table = AttributeTable::new();
        let service_changed = windows_gap_table(&mut table, name);
        (Server::new(table), Some(service_changed))
    } else {
        let gap = GapConfig::Peripheral(PeripheralConfig {
            name,
            appearance: &appearance::human_interface_device::KEYBOARD,
        });
        (Server::new_with_config(gap).unwrap(), None)
    };

    info!(
        "handles: report_map={} kbd={}/{:?} leds={} mouse={}/{:?} consumer={}/{:?}",
        server.hid.report_map.handle,
        server.hid.keyboard_in.handle,
        server.hid.keyboard_in.cccd_handle,
        server.hid.keyboard_leds.handle,
        server.hid.mouse_in.handle,
        server.hid.mouse_in.cccd_handle,
        server.hid.consumer_in.handle,
        server.hid.consumer_in.cccd_handle,
    );

    let app = async {
        if take_ota_boot_flag() {
            ota_mode(&mut peripheral, &server, &flash).await;
        }
        loop {
            let conn = match select3(
                advertise(&mut peripheral, &server, name, &advertise_params),
                OTA_REQUEST.wait(),
                PROFILE_SWITCH.wait(),
            )
            .await
            {
                Either3::First(Ok(conn)) => conn,
                Either3::First(Err(e)) => {
                    warn!("advertise error: {:?}", e);
                    Timer::after(Duration::from_secs(1)).await;
                    continue;
                }
                Either3::Second(()) => request_ota_reboot(),
                Either3::Third(p) => switch_profile_and_reboot(&flash, p),
            };
            info!("connected");
            // ボンディングを許可（これが無いと PairingComplete の bond が None になり保存されない）。
            let _ = conn.raw().set_bondable(true);
            match session(&server, &conn, &store, &flash, service_changed.as_ref()).await {
                SessionEnd::Ota => request_ota_reboot(),
                SessionEnd::Switch(p) => {
                    // ホストに押しっぱなしを残さないよう、切る前に全解放を送ってから切り替える
                    let _ = server.hid.keyboard_in.notify(&conn, &[0; 8], false).await;
                    let _ = server.hid.mouse_in.notify(&conn, &[0; 5], false).await;
                    conn.raw().disconnect();
                    Timer::after(Duration::from_millis(100)).await;
                    switch_profile_and_reboot(&flash, p)
                }
                SessionEnd::Disconnected => {}
            }
            info!("disconnected");
        }
    };
    let _ = join(runner.run(), app).await;
    loop {
        Timer::after(Duration::from_secs(1)).await;
    }
}

/// 2 台目（Windows）の GAP / GATT サービス。trouble-host の既定（`GapConfig`）との違いは 2 つ:
/// - GATT サービス（0x1801）に Service Changed（0x2A05、indicate）を置く。既定では 0x1801 が空で、Windows は
///   ペアリングの前に 0x1801 だけを見つけたまま、ペアリングの後にサービスを発見せず、HID の機器を作らなかった（2026-10-24。
///   docs/design/multi-host.md）。ペアリングの後にこれで「全部変わった」と知らせ、発見をやり直させる（`session`）
/// - GAP に Central Address Resolution を置かない（周辺機器には不要。ふつうの HID 機器にも無い）
/// （`RawMutex` は trouble-host が使う版の embassy-sync のもの。このクレートが直接使う版とは違う）
fn windows_gap_table<'d, M: trouble_host::__export::embassy_sync::blocking_mutex::raw::RawMutex, const MAX: usize>(
    table: &mut AttributeTable<'d, M, MAX>,
    name: &'d str,
) -> Characteristic<[u8; 4]> {
    let mut gap = table.add_service(Service::new(service::GAP));
    gap.add_characteristic_ro(characteristic::DEVICE_NAME, name);
    gap.add_characteristic_ro(characteristic::APPEARANCE, &appearance::human_interface_device::KEYBOARD);
    gap.build();
    let mut gatt = table.add_service(Service::new(service::GATT));
    let service_changed = gatt
        .add_characteristic_small(characteristic::SERVICE_CHANGED, [CharacteristicProp::Indicate], [0u8; 4])
        .build();
    gatt.build();
    service_changed
}

async fn advertise<'v, 's, C: Controller>(
    peripheral: &mut Peripheral<'v, C, DefaultPacketPool>,
    server: &'s Server<'v>,
    name: &str,
    params: &AdvertisementParameters,
) -> Result<GattConnection<'v, 's, DefaultPacketPool>, BleHostError<C::Error>> {
    let mut adv = [0u8; 31];
    let len = AdStructure::encode_slice(
        &[
            AdStructure::Flags(LE_GENERAL_DISCOVERABLE | BR_EDR_NOT_SUPPORTED),
            AdStructure::CompleteServiceUuids16(&[[0x12, 0x18]]),
            // 外見 = キーボード（0x03C1）。Windows 11 の標準の検出は、何の機器か分からないものを「デバイスの追加」の一覧に出さない
            AdStructure::Unknown { ty: 0x19, data: &[0xC1, 0x03] },
            AdStructure::CompleteLocalName(name.as_bytes()),
        ],
        &mut adv[..],
    )?;
    let advertiser = peripheral
        .advertise(
            params,
            Advertisement::ConnectableScannableUndirected { adv_data: &adv[..len], scan_data: &[] },
        )
        .await?;
    info!("advertising as {}", name);
    let conn = advertiser.accept().await?.with_attribute_server(server)?;
    Ok(conn)
}

/// 接続中の処理。GATT イベントを捌きつつ、USB キーボードのレポートを BLE へ流す。
async fn session(
    server: &Server<'_>,
    conn: &GattConnection<'_, '_, DefaultPacketPool>,
    store: &RefCell<BondStore<'_, '_>>,
    #[cfg_attr(not(feature = "trackpad"), allow(unused_variables))] flash: &RefCell<FlashStorage<'_>>,
    service_changed: Option<&Characteristic<[u8; 4]>>,
) -> SessionEnd {
    // 2 台目（Windows）: この接続でペアリングが済み、相手が Service Changed を購読したら、全体（0x0001〜0xFFFF）が
    // 変わったと 1 回だけ知らせ、サービスの発見をやり直させる（`windows_gap_table`）。
    let paired = Cell::new(false);
    let service_changed_subscribed = Cell::new(false);
    let service_changed_kick: Signal<CriticalSectionRawMutex, ()> = Signal::new();
    let service_changed_task = async {
        let Some(sc) = service_changed else {
            return core::future::pending::<()>().await;
        };
        loop {
            service_changed_kick.wait().await;
            if paired.get() && service_changed_subscribed.get() {
                info!("service changed: asking the host to discover the services again");
                if let Err(e) = sc.indicate(conn, &[0x01, 0x00, 0xff, 0xff], false).await {
                    warn!("service changed: indicate failed: {:?}", e);
                }
                return core::future::pending::<()>().await;
            }
        }
    };
    // 相手が自分から暗号化（ペアリング）を始めなければ、1.5 秒後に hikyaku から求める。つないだ瞬間に求めると、
    // Windows の「デバイスの追加」が始めるペアリングとぶつかって失敗した（2026-10-24。Mac・Linux は平気だった）。
    // 2 台目（Windows）では求めない: Windows は必ず自分からペアリングを始め、ペアリングの途中はまだ「暗号化なし」に
    // 見えるので、1.5 秒後の要求がペアリングに割り込んでいた（2026-10-24）。
    let security = async {
        if service_changed.is_some() {
            return core::future::pending::<()>().await;
        }
        Timer::after(Duration::from_millis(1500)).await;
        if matches!(conn.raw().security_level(), Ok(SecurityLevel::NoEncryption)) {
            info!("not encrypted yet, requesting security");
            let _ = conn.raw().request_security();
        }
        core::future::pending::<()>().await
    };
    // ボンド済みの相手の購読の状態（CCCD）を、再起動後の最初の接続で戻す。つなぎ直しても CCCD を書き直さない相手
    // （Windows）でも、再起動の後に通知が届くように（bond_store）。
    let peer = conn.raw().peer_identity();
    if let Some(bytes) = store.borrow_mut().cccd_to_restore(&peer) {
        match ClientAttTableView::try_from_raw(&bytes) {
            Ok(view) => {
                server.set_client_att_table(conn.raw(), &view);
                info!("restored subscriptions ({} bytes)", bytes.len());
            }
            Err(_) => warn!("saved subscriptions are invalid, ignoring"),
        }
    }
    let events_loop = async {
        loop {
            match conn.next().await {
                GattConnectionEvent::Disconnected { reason } => {
                    info!("disconnect: {:?}", reason);
                    break;
                }
                GattConnectionEvent::PairingComplete { security_level, bond } => {
                    info!("pairing complete: {:?} bonded={}", security_level, bond.is_some());
                    if let Some(bond) = bond {
                        store.borrow_mut().save(bond);
                    }
                    paired.set(true);
                    service_changed_kick.signal(());
                }
                GattConnectionEvent::PairingFailed(e) => warn!("pairing failed: {:?}", e),
                GattConnectionEvent::Gatt { event } => {
                    // OTA の書き込みは OTA モード以外では受け付けない。
                    let is_ota = matches!(&event, GattEvent::Write(w)
                        if w.handle() == server.ota.ctrl.handle || w.handle() == server.ota.data.handle);
                    if is_ota {
                        warn!("ota: write rejected (not in OTA mode)");
                        match event.reject(AttErrorCode::WRITE_NOT_PERMITTED) {
                            Ok(reply) => reply.send().await,
                            Err(e) => warn!("gatt error: {:?}", e),
                        }
                        continue;
                    }
                    // ショートカットリングのアプリからの要求
                    #[cfg(feature = "trackpad")]
                    if let GattEvent::Write(w) = &event {
                        if w.handle() == server.ring.ctrl.handle {
                            w.with_data(|_, d| ring_ctrl(d, flash));
                        }
                    }
                    match &event {
                        GattEvent::Write(w) => w.with_data(|_, d| debug!("gatt write handle={} data={:?}", w.handle(), d)),
                        GattEvent::Read(r) => debug!("gatt read handle={}", r.handle()),
                        _ => {}
                    }
                    // Service Changed の CCCD（bit 1 = indicate）
                    let service_changed_cccd = match (&event, service_changed.and_then(|sc| sc.cccd_handle)) {
                        (GattEvent::Write(w), Some(h)) if w.handle() == h => {
                            w.with_data(|_, d| Some(d.first().is_some_and(|b| b & 0x02 != 0)))
                        }
                        _ => None,
                    };
                    let is_write = matches!(&event, GattEvent::Write(_));
                    match event.accept() {
                        Ok(reply) => reply.send().await,
                        Err(e) => warn!("gatt error: {:?}", e),
                    }
                    // 購読の状態が変わったら保存する（変わっていなければ書かない）
                    if is_write {
                        if let Some(table) = server.get_client_att_table(conn.raw()) {
                            store.borrow_mut().save_cccd(&conn.raw().peer_identity(), table.raw());
                        }
                    }
                    if let Some(on) = service_changed_cccd {
                        info!("service changed: subscribed={}", on);
                        service_changed_subscribed.set(on);
                        service_changed_kick.signal(());
                    }
                }
                _ => {}
            }
        }
    };
    // 後回しにした ATT MTU 交換の応答（Windows が同じ要求を 2 回送る件。vendor/README.md）を、相手から ATT が 500 ms 来ていない
    // 静かなとき（遅くとも 20 秒後。Windows の時間切れは 30 秒）に送る。
    let deferred_mtu = async {
        loop {
            Timer::after(Duration::from_millis(100)).await;
            conn.raw().send_deferred_mtu_response(Duration::from_millis(500), Duration::from_secs(20));
        }
    };
    let events = select4(events_loop, security, service_changed_task, deferred_mtu);
    // 接続前に溜まったレポートは捨てる（古い押下が残って暴走しないように）。
    REPORTS.clear();
    let forward = async {
        if cfg!(feature = "selftest") {
            // `--features selftest`: 5 秒おきに "hello" を打鍵する。
            Timer::after(Duration::from_secs(5)).await;
            loop {
                for key in [0x0b_u8, 0x08, 0x0f, 0x0f, 0x12] {
                    let _ = server.hid.keyboard_in.notify(conn, &[0, 0, key, 0, 0, 0, 0, 0], false).await;
                    Timer::after(Duration::from_millis(30)).await;
                    let _ = server.hid.keyboard_in.notify(conn, &[0; 8], false).await;
                    Timer::after(Duration::from_millis(30)).await;
                }
                Timer::after(Duration::from_secs(5)).await;
            }
        }
        loop {
            let r = REPORTS.receive().await;
            log::trace!("forward report");
            let res = match r {
                Report::Key(v) => server.hid.keyboard_in.notify(conn, &v, false).await,
                Report::Mouse(v) => server.hid.mouse_in.notify(conn, &v, false).await,
                Report::Consumer(v) => server.hid.consumer_in.notify(conn, &v, false).await,
                Report::Ring(v) => server.ring.state.notify(conn, &v, false).await,
            };
            if let Err(e) = res {
                warn!("notify failed: {:?}", e);
            }
        }
    };
    let end = match select4(events, forward, OTA_REQUEST.wait(), PROFILE_SWITCH.wait()).await {
        Either4::Third(()) => SessionEnd::Ota,
        Either4::Fourth(p) => SessionEnd::Switch(p),
        _ => SessionEnd::Disconnected,
    };
    // 切断したら、アプリはいない。リングも閉じる。
    #[cfg(feature = "trackpad")]
    {
        trackpad::APP_PRESENT.store(false, core::sync::atomic::Ordering::Relaxed);
        trackpad::RING_CMD.signal(trackpad::RingCmd::Close);
    }
    end
}

/// ring.ctrl への書き込み（1 バイト目が命令。`hikyaku_pointer::ring::ctrl`）。
#[cfg(feature = "trackpad")]
fn ring_ctrl(d: &[u8], flash: &RefCell<FlashStorage<'_>>) {
    use core::sync::atomic::Ordering;
    use hikyaku_pointer::{ring::{Command, Event}, Rotation};
    // 今の設定をアプリへ返す
    let send_settings = || {
        let s = settings::get();
        let rotation = Rotation::from_quarters(s.rotation).unwrap_or_default();
        let event = Event::Settings { rotation, profile: s.profile, scroll_invert: s.scroll_invert_now() };
        let _ = REPORTS.try_send(Report::Ring(event.encode(0)));
    };
    match Command::parse(d) {
        Some(Command::Hello) => {
            info!("ring: app connected");
            trackpad::APP_PRESENT.store(true, Ordering::Relaxed);
            send_settings();
        }
        Some(Command::SetRotation(r)) => {
            settings::update(flash, |s| s.rotation = r.quarters());
            trackpad::ROTATION.store(r.quarters(), Ordering::Relaxed);
            send_settings();
        }
        Some(Command::SetScrollInvert(on)) => {
            let s = settings::update(flash, |s| {
                let bit = 1 << s.profile;
                s.scroll_invert = if on { s.scroll_invert | bit } else { s.scroll_invert & !bit };
            });
            trackpad::SCROLL_INVERT.store(s.scroll_invert_now(), Ordering::Relaxed);
            send_settings();
        }
        Some(Command::SwitchProfile(p)) => {
            if p != settings::get().profile {
                PROFILE_SWITCH.signal(p);
            }
        }
        Some(Command::GetSettings) => send_settings(),
        Some(Command::Close) => trackpad::RING_CMD.signal(trackpad::RingCmd::Close),
        Some(Command::Open) => trackpad::RING_CMD.signal(trackpad::RingCmd::Open),
        // アプリの代わりに、本物のキーボード入力として押して離す（アクセシビリティの許可が要らない）
        Some(Command::Key { modifiers, key }) => {
            let _ = REPORTS.try_send(Report::Key([modifiers, 0, key, 0, 0, 0, 0, 0]));
            let _ = REPORTS.try_send(Report::Key([0; 8]));
        }
        Some(Command::Consumer(usage)) => {
            let _ = REPORTS.try_send(Report::Consumer(usage.to_le_bytes()));
            let _ = REPORTS.try_send(Report::Consumer([0; 2]));
        }
        None => warn!("ring: unknown command {:?}", d),
    }
}

enum SessionEnd {
    Disconnected,
    /// キーボードから OTA モードが要求された。
    Ota,
    /// 送り先の切り替えが要求された（値は切り替え先）。
    Switch(u8),
}

enum Action {
    None,
    Notify([u8; ota::CTRL_LEN]),
    /// 通知を送ってから再起動する。
    Reboot([u8; ota::CTRL_LEN]),
}

/// OTA モード。ホストとの接続は切り、`hikyaku-OTA` として PC からの接続を待つ。終わったら（または時間切れで）再起動する。
async fn ota_mode<'v, C: Controller>(
    peripheral: &mut Peripheral<'v, C, DefaultPacketPool>,
    server: &Server<'v>,
    flash: &RefCell<FlashStorage<'_>>,
) -> ! {
    match ota::key() {
        None => warn!("ota: HIKYAKU_OTA_KEY was not set at build time; OTA is disabled"),
        Some(key) => {
            info!("ota: mode on for 180 s (advertising as hikyaku-OTA)");
            let mut ota = ota::Ota::new(flash, key);
            let r = with_timeout(Duration::from_secs(180), ota_session(peripheral, server, &mut ota)).await;
            info!("ota: {}", if r.is_ok() { "finished" } else { "timed out" });
        }
    }
    Timer::after(Duration::from_millis(300)).await;
    esp_hal::system::software_reset()
}

async fn ota_session<'v, C: Controller>(
    peripheral: &mut Peripheral<'v, C, DefaultPacketPool>,
    server: &Server<'v>,
    ota: &mut ota::Ota<'_, '_>,
) {
    let (ctrl_h, data_h) = (server.ota.ctrl.handle, server.ota.data.handle);
    // 接続を受ける相手を PC に限る（指定がなければ誰でも。HMAC 認証は常に必要）。
    let mut params = AdvertisementParameters::default();
    if let Some(peer) = ota::peer() {
        let addr = Address::new(AddrKind::PUBLIC, BdAddr::new(peer));
        match peripheral.set_filter_accept_list(&[addr]).await {
            Ok(()) => {
                params.filter_policy = AdvFilterPolicy::FilterConn;
                info!("ota: accepting connections only from the configured PC");
            }
            Err(_) => warn!("ota: could not set the accept list"),
        }
    } else {
        warn!("ota: HIKYAKU_OTA_PEER not set; accepting any central");
    }
    loop {
        let conn = match advertise(peripheral, server, "hikyaku-OTA", &params).await {
            Ok(c) => c,
            Err(e) => {
                warn!("ota: advertise error: {:?}", e);
                Timer::after(Duration::from_secs(1)).await;
                continue;
            }
        };
        info!("ota: connected");
        loop {
            match conn.next().await {
                GattConnectionEvent::Disconnected { .. } => break,
                GattConnectionEvent::Gatt { event } => {
                    let action = match &event {
                        GattEvent::Write(w) if w.handle() == ctrl_h => w.with_data(|_, d| match ota.ctrl(d) {
                            ota::Reply::None => Action::None,
                            ota::Reply::Notify(n) => Action::Notify(n),
                            ota::Reply::NotifyThenReboot(n) => Action::Reboot(n),
                        }),
                        GattEvent::Write(w) if w.handle() == data_h => w.with_data(|_, d| match ota.data(d) {
                            Ok(Some(off)) => Action::Notify(ota::Ota::progress_note(off)),
                            Ok(None) => Action::None,
                            Err(st) => {
                                warn!("ota: data error: {:?}", st);
                                Action::Notify(ota::Ota::error_note(st))
                            }
                        }),
                        _ => Action::None,
                    };
                    match event.accept() {
                        Ok(reply) => reply.send().await,
                        Err(e) => warn!("gatt error: {:?}", e),
                    }
                    match action {
                        Action::None => {}
                        Action::Notify(n) => {
                            let _ = server.ota.ctrl.notify(&conn, &n, false).await;
                        }
                        Action::Reboot(n) => {
                            let _ = server.ota.ctrl.notify(&conn, &n, false).await;
                            Timer::after(Duration::from_millis(500)).await;
                            return;
                        }
                    }
                }
                _ => {}
            }
        }
        info!("ota: disconnected, waiting again");
    }
}
