yuzukq/hikyaku/(commit log)

2026-09-29 Add Rust workspace: hikyaku-hid (no_std) and hid-probe tool
2026-09-29 Add ESP32-C3 BLE HID firmware (Rust, trouble) and update roadmap
2026-09-29 Forward HID reports from PC over USB serial to BLE; add hid-probe bridge
2026-09-29 bridge: print ESP log; roadmap: Mac passthrough verified
2026-09-29 roadmap: decide to procure ESP32-S3
2026-10-08 Add ESP32-S3 firmware (BLE HID ported from C3, verified end to end)
2026-10-08 S3: USB host keyboard task with UART logging; add C3 UART-to-USB bridge firmware
2026-10-08 Roadmap: trackpad wiring plan from TM035035 spec
2026-10-08 Add docs/ (parts, wiring, power, CH9102F, trackpad, keyboard, firmware), test scripts; tidy README/ROADMAP
2026-10-08 Add Pinnacle SPI driver and pointer logic crates; wire trackpad task into S3 firmware behind a feature
2026-10-08 Docs: mark multi-host switching as a later idea, record the original request
2026-10-11 Trackpad pins -> GPIO10-13 (SPI2 default); board is not a XIAO, so use GPIO numbers in docs
2026-10-11 Docs: record the board as ESP32-S3FH4R2 (AliExpress)
2026-10-11 Trackpad: SPI link verified on hardware (Pinnacle id 0x07, version 0x3a)
2026-10-11 Add BLE OTA (receiver in firmware, tools/ota), pointer noise suppression, trace + replay tool
    [partitions.csv]
2026-10-11 Pinnacle: checked read (2x + majority) and disagreement counter for bit7 glitches
    [lib.rs, mod.rs]
2026-10-11 gatt_server: track CCCD state for 4 peers (fixes second central being unable to subscribe)
    [main.rs]
2026-10-11 OTA: enter OTA mode by rebooting with an RTC flag
    [main.rs]
2026-10-11 Trackpad: SPI 250kHz (1MHz had frequent read errors)
    [main.rs, mod.rs]
2026-10-11 Pointer: 3-point median filter; Pinnacle: raw bytes; trace build sweeps SPI frequency and reports MSB statistics
2026-10-12 Trackpad trace build: avoid Instant underflow panic at boot
    [mod.rs]
2026-10-12 Pinnacle: port QMK init (reset, ADC attenuation via ERA, calibration); torn-read diagnostic; absolute coordinates by default
    [lib.rs, mod.rs]
2026-10-12 Pinnacle: keep raw relative bytes for diagnostics; trace logs them
2026-10-12 Pinnacle: CS setup delay; firmware SPI self-test (mode x freq x cs-setup) via register read-back
2026-10-12 Trackpad: SPI 2MHz (low clocks corrupt MSB, found by register read-back); relative gain 0.4
2026-10-12 Trackpad: relative mode exactly like ZMK/Cirque sample (1:1 deltas, 3-byte packets, pad-side Y invert, ZIdle 0); SPI 4MHz
    [lib.rs, main.rs, mod.rs]
2026-10-12 Trackpad: map pad axes to screen (pad is mounted rotated 90 degrees)
2026-10-12 Trackpad: drop pad-side Y invert in relative mode (it suppressed Y); orient in firmware
    [lib.rs, mod.rs]
2026-10-12 Trackpad: back to SPI 2MHz (Y missing and dropouts at 4MHz); tidy warnings
    [main.rs, mod.rs]
2026-10-12 Trackpad: invert screen X, gain x4 like QMK relative default; uart_cap reconnects on errors
    [mod.rs, uart_cap.py]
2026-10-12 Avoid serial port contention: uart_cap opens only CH9102F; hk flash refuses if port is busy
    [uart_cap.py]
2026-10-12 Self-test: more repetitions around 2MHz to detect contact problems
    [mod.rs]
2026-10-12 Pinnacle: refuse to start unless firmware id is 0x07 (disconnected wiring sent garbage motion)
2026-10-12 Trackpad: gain x2 (x4 was too fast)
    [mod.rs]
2026-10-12 Revert "Trackpad: disable pad-side tap" (back to the good version, only the gain differs)
    [mod.rs]
2026-10-12 Docs: final assembly wiring (CH9102F as power input), update power/wiring/parts/README/ROADMAP
2026-10-12 Docs: handoff notes for the cloud session, add trackpad traces
2026-10-12 Pointer: extract relative-mode conversion into hikyaku_pointer::relative with replay tests
    Move the relative-mode packet -> mouse report conversion (axis swap,
    screen inversion, gain, carry-over, splitting into i8 reports) out of
    firmware/hikyaku-s3/src/bin/trackpad/mod.rs into a pure, host-testable
    module. The firmware now feeds Relay::push / Relay::poll and keeps only
    the SPI reading, logging and statistics.
    Tests compare the module against a verbatim copy of the old firmware
    loop (Golden) on the recorded trace tools/traces/2026-10-13-relative-all.log
    and on random packets, including scroll mode: the output is bit-identical.
    parse_trace_line reads the 'rel <ms> raw=[..]' log lines (corrup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
    [lib.rs, mod.rs, relative.rs]
2026-10-12 Trackpad: stillness filter behind trackpad-still-filter (default off)
    Suppress the +-1..2 cursor wobble while a finger rests on the pad.
    In the 'still' state deltas are accumulated and only released, in
    full, once the accumulated displacement reaches the threshold (3 pad
    units); a single packet at or above the threshold passes through
    untouched, so a quick touch reacts immediately. Once moving, deltas
    pass 1:1 until the last 8 packets net less than the threshold, so slow
    deliberate motion is not chopped. A 100ms gap (finger lifted) resets.
    Host tests: resting jitter yields no reports; a quick touch is
    unchanged; slow 1-unit motion keeps its total distance; small landing
    motion followed by a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
    [mod.rs, relative.rs]
2026-10-12 Trackpad: software tap detection behind trackpad-soft-tap (default off)
    Reduce spurious clicks during swipes by disabling the pad's own tap
    (FeedConfig2 AllTapDisable) and detecting taps in software from the
    timing of relative packets: a touch is the run of packets with gaps
    under 30ms; it is a tap when it lasts at most 200ms, moves at most 10
    pad units in total (|dx|+|dy|), and ends with a zero packet. The zero
    packet is the pad's ZIdle 'finger lifted' marker, so the feature sets
    ZIdle = 5 (QMK's value) via the new RelativeOptions::z_idle; the
    default stays 0 and the default init sequence is unchanged. Requiring
    the lift marker avoids a false click when the pad goes quiet while a
    finger res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
    [lib.rs, mod.rs, relative.rs]
2026-10-12 Trackpad: trackpad-sens-1x/2x/3x features to pick the ADC attenuation (default stays 4X)
    Candidate for a better response to light, quick touches: 2X and 1X were
    untried. One feature at a time; two at once is a compile error. The
    default build is unchanged. Firmware build unverified in this session.
    Claude-Session: https://claude.ai/code/session_01Pn7ez7kGiKXpnHMbSZDN8G
    [mod.rs]
2026-10-12 Docs: OTA failure hypotheses, usb-trace feature, cloud-session handoff notes and cleanup proposal
    - docs/ota.md: stage-by-stage hypotheses (chord detection, RTC flag,
    accept list address kind, CCCD/fixed-length ctrl writes, flash erase
    stalling the BLE controller) with what to look for in the logs.
    - usb-trace feature: log each USB key report (modifiers + key codes) to
    check whether the OTA chord actually reaches the S3 in one report.
    - docs/handoff.md: what this session did, what is verified on the host
    and what is not, how to try each feature one at a time, the design of
    the still filter and soft tap, and a cleanup proposal (absolute-mode
    path, warnings) left for the owner to d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
    [main.rs]
2026-10-14 配線画像を追加
2026-10-14 Diagnostics: usb-log (logs over S3 USB-C) and trackpad-probe (pin/short test); docs: converter board was reversed
    - usb-log: esp-println over USB Serial/JTAG instead of UART0, USB host disabled
    (default feature log-uart keeps the normal build unchanged); tools/hk usb-log
    - trackpad-probe: reads DR/MISO with pull-up/pull-down before SPI, and drives
    GPIO9..13 one by one to find shorts
    - uart_cap.py: UART_CAP_VENDOR to pick the port; set DTR/RTS before opening
    - assembly/wiring docs: on the board, the FPC converter's printed numbers were
    the reverse of the pad's J1 numbers; rotating the converter 180 degrees fixed it
    Claude-Session: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
    [main.rs, uart_cap.py]
2026-10-14 LED: onboard RGB LED (GPIO48) shows trackpad state: red while calibrating, green when ready, blue if the pad is not found
    WS2812-compatible LED on the ESP32-S3 SuperMini, driven by RMT channel 0.
    Claude-Session: https://claude.ai/code/session_01R2T4rmmtYcc8syE5BEs8KZ
2026-10-14 Trackpad: log dropped reports and max poll gap; uart_cap: don't reset the S3 when opening its USB port
    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
    [mod.rs, uart_cap.py]
2026-10-14 Trackpad: default touch sensitivity 2X (was 4X); add trackpad-sens-4x; board trace
    On the soldered board, 4X (the least sensitive) lost the finger on and off:
    drawing circles for 20 s produced only 4-5 s of packets and almost no
    left/right motion. With 2X, motion and taps felt right ("perfect") on the Mac,
    with 0 dropped reports. trackpad-sens-2x is kept (same as the default).
    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
2026-10-14 Docs: v1 state (keyboard + trackpad on the soldered board), CH9102F RX broken, LED; ignore .DS_Store
    - README/ROADMAP: Phase 4 done (relative mode, sensitivity 2X, LED), board steps done,
    remaining work (battery test, CH9102F RX, PCB idea)
    - handoff: current state and the "don't touch until green / let the owner press RESET" rule
    - firmware.md: LED, usb-log/trackpad-probe features, dropped/max_gap_ms counters
    - usb-serial-ch9102f.md: RX stopped working after desoldering; logs via usb-log
    - assembly.md: link the owner's wiring image, 2026-10-15 result
    - untrack .DS_Store
    Claude-Session: https://claude.ai/code/session_01R2T4rmmtYcc8syE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
2026-10-14 Docs: works on a mobile battery; next up: filter and power optimization
    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
2026-10-18 ケースを作った
    [Buttom.stl, Top.stl, hikyaku.f3d]
2026-10-20 Roadmap: two-finger scroll as next candidate; Phase 9 shortcut ring (Mac app) with design notes
    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
2026-10-20 Trackpad scroll while F24 is held (inverted direction); USB keyboard status on the LED; serial-bridge + hid-probe evbridge for testing with the PC keyboard
    - forward_key: strip F24 from the boot report and set SCROLL_MODE while it is held
    (7sPro: F24 on a thumb key's hold via QMK mod-tap); detach clears it
    - relative::Config::scroll_invert (firmware default true; golden tests keep the old direction)
    - LED: white = keyboard ready, cyan = first key, yellow/purple/orange = enumerate failed /
    no boot keyboard / read error (to debug the TOFU60 that doesn't pass keys)
    - serial-bridge feature: key reports from the PC over USB Serial/JTAG; hid-probe evbridge
    reads evdev (keyd's virtual keyboar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
    [lib.rs, main.rs, mod.rs, relative.rs]
2026-10-20 3dプリンタの印刷誤差を考慮して数ミリ円形を大きくした．
    [Top_new.stl]
2026-10-20 Ring: firmware ring mode (F23 / app toggles, absolute mode while open), BLE ring service, Linux viewer, Mac probe
    - pinnacle: parse_absolute / read_absolute (11-bit mask) and set_absolute (flip FeedConfig1 bit1, set ZIdle)
    - pointer::ring: pad position -> screen angle (0 = up, clockwise) and radius (rim = 1000),
    no_std atan2 approximation (< 0.1 deg) and integer sqrt; 12-byte event encoding; ctrl codes
    - firmware: F23 toggles the ring (not sent to the Mac), Esc closes it while open; ring opens only
    after the app sent HELLO; while open, cursor is frozen and ~100 Hz position events are notified;
    closes on app CLOSE / F23 / Esc / 5 s without touch / disconnect
    - GATT: RingService 6b9a0010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
    [lib.rs, main.rs, mod.rs, ring.rs]
2026-10-20 Ring viewer: pair on first connect; connect via the BlueZ device path when the PC already holds the connection
    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
2026-10-20 Ring: don't invert X for the absolute position (left/right was mirrored on the pad)
    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
    [ring.rs]
2026-10-20 Ring: app commands to send key combos and media keys through hikyaku; protocol and Mac app handoff in ring.md
    - ring::Command::parse: 00 HELLO, 01 CLOSE, 02 OPEN, 10 mm kk (key combo), 11 lo hi (consumer usage)
    - firmware: key combos / media keys are pressed and released as real HID input (no Accessibility permission)
    - RingProbe / ring viewer: +/- volume, k = Command+Space
    - docs/design/ring.md: confirmed results (macOS lets the app use the ring service of the HID-connected
    hikyaku), final protocol, ZIdle repeats and pre-lift position rule, Mac app spec for the Mac session
    - ROADMAP: Phase 9 firmware/probe steps done
    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
2026-10-20 Ring app: knob gauge follows the finger instead of waiting for the real value
    - The gauge was only refreshed by reading the volume 150ms after a step, and each new step postponed
    that read, so while turning it lagged until the finger stopped
    - Each step now moves the readout to the expected value at once (volume key = 1/16, seek = step seconds),
    and the sub-step rotation is added so the arc moves with the finger; the real value is read 300ms after turning stops
    - Dropped the 0.2s arc animation
2026-10-20 Handoff: current state as of 2026-10-21 (F24 scroll, shortcut ring done with the Mac app)
    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
2026-10-21 Button on GPIO8: tap = right click, hold = scroll, double tap = ring
    - One MX switch between GPIO8 and GND (internal pull-up), so scroll, the ring and right click work without the keyboard
    - Press starts scrolling at once; moving the pad while held makes it a hold (no click on release)
    - A short press without moving waits 250ms for a second press: second press toggles the ring (like F23), otherwise right click
    - Logic in hikyaku-pointer::button with host tests (debounce, wraparound); the trackpad task polls it every 5ms
    - No right click while the ring is open; firmware builds, switch not wired yet so untested on hardware
    Claude-Session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
    [button.rs, lib.rs, main.rs, mod.rs]
2026-10-21 Button: use GPIO7 instead of GPIO8 (nothing next to it on the board, easier to solder)
    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
2026-10-21 Button: move to GPIO6 (the GPIO7 pin on the board is broken)
    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
    [main.rs, mod.rs]
2026-10-21 Button: confirmed on hardware (right click, hold to scroll, double tap for the ring)
    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
2026-10-21 Button closes the ring with a single press; a bit less scroll per finger movement
    - While the ring is open (including knob mode), pressing the button closes it at once; that press is
    swallowed (Button::ignore_press), so it neither scrolls nor right-clicks. The Mac app follows the closed event
    - SCROLL_DIV 8 -> 10: about 20% less scrolling for the same finger movement (owner's request)
    - Golden and fixed-number tests pin scroll_div 8 (they copy the 2026-10-13 firmware)
    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
    [button.rs, mod.rs, relative.rs]
2026-10-21 Scroll: SCROLL_DIV 10 -> 12 (still a bit too much scrolling per finger movement)
    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
    [mod.rs, relative.rs]
2026-10-21 Cursor 2x -> 1.8x (fractional gain with carried remainder); scroll 14 -> 16
    - Config gets gain_div: gain / gain_div, the sub-unit remainder carries to the next packet so slow moves aren't lost
    - Golden tests pin gain 2 / div 1 / scroll 8 (copies of the 2026-10-13 firmware)
    - Both slowed on the owner's request
    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
2026-10-23 Device rotation (0/90/180/270) set from the Mac app's settings, with a hikyaku drawing to pick from
    - hikyaku-pointer: Rotation (quarter turns clockwise); relative Config.rotation turns cursor and scroll after the
    orientation fix; ring Geometry.rotation adds to the angle; Event::Settings (kind 4), commands 20 q / 21
    - Firmware: trackpad::ROTATION applied live; saved in its own flash sector (nvs 0xA000, settings module) and loaded at boot;
    HELLO, 21 and 20 answer with the settings event. GATT layout unchanged, so no re-pairing
    - Mac app: Orientation tab drawing hikyaku (blue plate, black pad, reset bottom-left, orange switch bottom-right) in four
    rotations; ring action Open settings; se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
    [lib.rs, main.rs, mod.rs, relative.rs, ring.rs]
2026-10-23 ROADMAP: device rotation verified on hardware
    The owner checked selection, cursor, scroll, all eight ring directions, persistence across a power cycle and returning to 0°.
    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
2026-10-23 Handoff: device rotation is done and verified
    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
2026-10-23 USB: open the boot keyboard ourselves so the TOFU60 works; reset recovery, timeouts and retries
    - KbdHandler::try_register re-reads the configuration descriptor and the TOFU60 (KBDfans Og60) stops answering there,
    so registration never finished. open_keyboard uses the descriptor read during enumeration, then sends SET_PROTOCOL
    and SET_IDLE with timeouts (failures are logged and ignored); open_media_pipe also reuses it
    - Wait 100ms after a bus reset (including attach) before talking to the device: the TOFU60 gave BadResponse otherwise
    - Enumeration and control transfers time out; a failed enumeration retries via bus reset up to 3 times instead of
    waiting for a replug (yellow LED only af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
    [main.rs]
2026-10-23 PCB: KiCad project with the schematic for the S3 carrier board
    Sockets for the S3 board (two 1x9 rows), the FFC 12P adapter (2x6) and the
    CH9102F module (2x4), plus two MX hot-swap switches on GPIO6 and GPIO7.
    The FFC socket pad k takes the adapter's printed pin k, which is trackpad J1
    pin 13-k: the same wiring as the universal board with the adapter turned 180°.
    5V goes straight from the CH9102F to the S3 with no programming jumper.
    [hikyaku.kicad_pcb, hikyaku.kicad_sch]
2026-10-23 Docs: catch up with the board as built and start the PCB notes
    - pcb.md: footprints, nets, FFC socket orientation (pad k = adapter print k),
    CH9102F 2x4 pinout, 1:1 print checks before ordering, kicad-cli usage
    - S3 board is the ESP32-S3 SuperMini; pin layout table and the vendor pinout image
    - FFC adapter socket is 2x6, not 1x12
    - No 5V programming jumper was fitted: unplug the CH9102F USB before flashing
    (assembly, power, wiring, firmware)
    - Flashing needs no BOOT; old BOOT steps kept as the fallback
    - GPIO6 button, GPIO48 LED and the planned GPIO7 switch in the pin table;
    GPIO7 failed on the universal board side, not on the S3
    - ROADMAP/README/handoff: CH9102F replaced, PCB work in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
2026-10-23 gitignore: KiCad autosave, -bak files and pcb/out/ for generated outputs
    KiCad's own .history/.gitignore only applies to its internal snapshot repo,
    so the project-level rules live in the root .gitignore. pcb.md lists what
    is committed and points gerber output at pcb/out/.
2026-10-24 Two profiles (hikyaku / hikyaku2) with their own address, name and bonds; switch by F21/F22, 3 s hold or app
    - Decided in multi-host.md: one connection at a time, a separate BLE identity per host (stability and power over
    instant switching). Profile 1 keeps the old address, so the Mac needs no re-pairing
    - Switching saves the profile and reboots; the switch reboot skips the 3 s USB flashing grace. LED blinks blue
    profile-number times at boot
    - Bonds stored per profile (HKB2, HKB1 read as profile 1); settings HKS2 adds profile and per-profile scroll invert
    (default: Mac inverted, Windows not). Commands 22 v (scroll invert) and 23 p (switch); settings event carries both
    - Button: holding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
    [button.rs, lib.rs, main.rs, mod.rs, ring.rs]
2026-10-24 Windows app (C# / WPF) and probe in win/, built and tested from Linux via Docker
    - RingCore: protocol (incl. settings event with profile and scroll invert, commands 20-23), ring state machine,
    config JSON, Windows virtual key -> HID usage; 35 xUnit tests ported from the Mac app
    - RingProbe: console check that Windows lets an app open the ring service of the HID-connected hikyaku2
    - HikyakuRing: tray app, Ctrl+Alt+R, non-activating click-through overlay placed in physical pixels per monitor DPI,
    knob view, settings window (items with key recording, tuning, device orientation drawing, profile switch and
    per-profile scroll invert, start with Windows), volume readout via Core Audio, bright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
2026-10-24 LED shows the profile by color (green / blue); GitHub Actions builds the Windows app into a release
    - Ready color: profile 1 green, profile 2 blue (replaces the boot blink count). A missing pad now blinks red and the
    profile color instead of steady blue
    - .github/workflows/windows.yml: on win/ changes (or by hand), test and publish on windows-latest, upload the zip as an
    artifact and recreate the windows-latest prerelease with hikyaku-windows.zip
    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
    [main.rs, mod.rs]
2026-10-24 Advertise the keyboard appearance so Windows lists hikyaku2 in Add device
    - hikyaku2 was advertising (seen from Linux) but Windows did not show it; Windows 11's default discovery hides devices
    of unknown type. Appearance 0x03C1 (keyboard) added to the advertising data
    - win/README: switch discovery to Advanced if it still does not show; do not pair hikyaku2 on the Mac
    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
2026-10-24 Ask for encryption only if the host has not started pairing within 1.5 s
    - Windows failed to pair with hikyaku2 ("connect the device again") while Linux paired fine with the same firmware.
    The peripheral's security request on connect likely collides with the pairing Windows starts from Add device
    - Now the session waits 1.5 s and sends the security request only when the link is still unencrypted
    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
    [main.rs]
2026-10-24 Windows: probe and app survive BluetoothLEDevice.FromIdAsync throwing, and also try the profile addresses
    - On Windows the probe found hikyaku2 among paired devices, then FromIdAsync threw FileNotFoundException and the
    console closed. Now each step is caught and printed, the device is also opened by its BLE address, and the probe
    waits for Enter before closing
    - The app's lookup does the same and logs the errors
    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
2026-10-24 Profile 2 distributes a non-zero IRK (static address kept) for Windows; GATT trace logs at debug
    - Windows paired with hikyaku2 at the SMP level but never read or subscribed to anything afterwards, and its device
    entry stayed unpaired with no device instance. trouble-host sends an all-zero IRK when the host has no local IRK;
    common BLE keyboards send a real one. Profile 2 now enables a fixed IRK and keeps advertising with its static
    random address (own_addr_kind RANDOM), profile 1 (Mac) is unchanged
    - Report map handle added to the boot log; per-report debug log lowered to trace so ESP_LOG=info,hikyaku_s3=debug
    shows only GATT reads and writes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
    [main.rs]
2026-10-24 Profile 2 (Windows): own GAP/GATT services with Service Changed, indicated after pairing
    Windows paired with hikyaku2 but only ever created the 0x1801 child: before
    pairing it looks for Service Changed in 0x1801 (empty in trouble-host's
    GapConfig), and after encryption it sent no ATT request at all, so the HID
    device was never created (ETW HCI trace, 2026-10-24). Profile 2 now builds
    its own GAP (without Central Address Resolution) and GATT service with a
    Service Changed characteristic, and indicates 0x0001-0xFFFF once the host
    has paired and subscribed. Profile 1 (Mac) keeps the same handles.
    Claude-Session: https://claude.ai/code/ses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
2026-10-24 Profile 2: never send the peripheral security request (it interrupted Windows' own pairing)
    - With the TP-Link adapter, Windows started pairing and 1 s later the 1.5 s security request fired, because the link
    still reads as unencrypted while pairing is in progress. Windows always initiates pairing, so profile 2 now leaves
    it to the host; profile 1 (Mac) keeps the delayed request
    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
2026-10-24 Vendor trouble-host 0.7.0 and answer the ATT MTU exchange only once per connection
    - With a TP-Link (Realtek) adapter, Windows sent the same Exchange MTU Request twice in the same millisecond and
    disconnected right after the second response, even in the middle of SMP pairing (Windows ETW, 2026-10-24).
    Stock trouble-host answers every request. The vendored copy answers the first one per connection and drops the rest
    with a warning (connection_manager first_att_mtu_request, host.rs); the spec allows one exchange per connection
    - Used via [patch.crates-io] so anyone can build it; vendor/README.md lists the change
    Claude-Session: htt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
2026-10-24 Save each bonded host's subscriptions (CCCDs) in flash and restore them after a reboot
    - Windows does not rewrite the HID CCCDs when it reconnects to a bonded device (it expects the server to remember,
    as the spec says). trouble-host keeps them only in RAM, so after a hikyaku reboot (reset, profile switch, power)
    the keyboard and mouse notifications would stop reaching Windows
    - bond_store HKB3 keeps ClientAttTable::raw() next to each bond (HKB2 / HKB1 still read); session restores it on the
    first connection from that host after boot and saves it after GATT writes when it changed (no flash write otherwise)
    - session now takes DefaultPacketPool (the server's client-table API is not gene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
    [main.rs, mod.rs]
2026-10-24 Vendored trouble-host: L2CAP length of the MTU error response from the ATT PDU size (5, not 3)
    - Spotted by the Windows-side session: the deferred reply kept the length of the MTU response, so Windows would have
    received an L2CAP frame whose length did not match its data. The length now comes from codec::Type::size of the PDU
    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
2026-10-24 Mac app gets the profile tab; Mac CI build; installers that replace the old app on both platforms
    - Mac: settings event carries profile and scroll invert; switchProfile / setScrollInvert commands; a 送り先 tab like
    the Windows app (switch between hikyaku and hikyaku2, per-profile scroll direction); tests updated
    - Mac: build.sh stamps the git revision into CFBundleVersion (shown in the menu) and --install puts the app into
    /Applications via install.sh, which also takes the release zip (quits the running app, replaces, clears quarantine)
    - .github/workflows/mac.yml: swift test + ad-hoc build on macos-15, zip into the mac-latest release
    - Windows: install.cmd / install.ps1 (UTF-8 BOM) i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
2026-10-24 Windows installer: start the app with its install folder as the working directory
    - Start-Process inherited the extracted folder (e.g. Downloads) as the app's current directory, so that folder could
    not be deleted while the app ran. Also install.cmd leaves the folder before its final pause
    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
2026-10-25 フットプリントをホットスワップからはんだ付け版に更新
    [hikyaku.kicad_pcb, hikyaku.kicad_sch]
2026-10-26 大まかに配置
    [hikyaku.kicad_pcb]
2026-10-26 エッジカットを雑に引いた．
    [hikyaku.kicad_pcb]
2026-10-26 エッジカット完成
    [hikyaku.kicad_pcb]
2026-10-26 PCB: 3D models for placement checks (low-profile sockets, modules, MX switch)
    - Simple VRML boxes for the S3, CH9102F and FFC adapter on 3 mm sockets, generated by gen_models.py; module sizes and pin positions are still estimates
    - MX switch model from usagi.kicad (MIT), converted from VRML 1.0 to 2.0 because KiCad 10 does not load 1.0
    - The footprints already point at these files
2026-10-26 テキスト入れた
    [hikyaku.kicad_pcb]
2026-10-28 m2の穴を開けた
    [hikyaku.kicad_pcb]
2026-10-28 Mac: show the ring over full-screen apps; never run an item from a ring that isn't on screen (#3)
    - The overlay panel moves from .popUpMenu to .screenSaver and gains .canJoinAllApplications. Apple's recipe for overlays above other apps' full-screen Spaces is a non-activating NSPanel in an accessory app at .screenSaver; lower levels sit beneath full-screen content
    - Safety net: if the ring is still not visible on screen when a finger is released (occluded or not on the current Space), the item is not run and the knob is not entered; the ring just closes. The firmware is already in ring mode then, so this stops shortcuts firing from a ring nobody can see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
2026-10-28 Mac / Windows: bring the settings window in front of other apps when the ring opens it (#2)
    - Mac: un-minimize, then orderFrontRegardless before activating. When the ring opens settings, another app is in use and macOS 14+ cooperative activation can refuse NSApp.activate(), so makeKeyAndOrderFront alone left an already-open window behind that app
    - Windows: Activate is refused for a background app (the window only flashes in the taskbar). Set Topmost on and off to raise the window above other apps, then SetForegroundWindow while briefly attached to the foreground thread's input so it also gets keyboard focus
    Claude-Session: https://cla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
2026-10-28 Mac: リングから開いた設定画面を、デスクトップでもほかのアプリの前に出す
    NSApp.activate() は協調的なアクティベーションで断られ、orderFrontRegardless を足しても
    設定画面はそれまで有効だったアプリのウィンドウの裏に出た（実機で確認、試験用プログラムでも再現）。
    activate(ignoringOtherApps: true) にすると、デスクトップでもフルスクリーンの上でも前に出てキーになる。
2026-10-28 PCB: autorouted draft (power 0.5mm, signals 0.25mm, GND as F/B pours)
    - Net classes: Power (+5V, +3V3, GND) 0.5mm / via 0.8, Default 0.25mm
    - All signal and power nets routed with a script-based 2-layer grid router; GND is two copper zones, filled
    - DRC: 0 unconnected, no clearance errors; only silk text thickness and two thermal-relief warnings
    - For review: nothing here is hand-tuned
    [hikyaku.kicad_pcb]
2026-10-28 PCB: remove the autorouted draft, keep the net classes
    - Tracks, vias and GND zones deleted so the routing can be done by hand
    - Net classes in hikyaku.kicad_pro stay: Power 0.5mm, Default 0.25mm
    [hikyaku.kicad_pcb]
2026-10-29 ガーバーデータを生成て発注した
    [hikyaku-B_Cu.gbl, hikyaku-B_Mask.gbs, hikyaku-B_Silkscreen.gbo, hikyaku-Edge_Cuts.gm1, hikyaku-F_Cu.gtl, hikyaku-F_Mask.gts, hikyaku-F_Silkscreen.gto, hikyaku-NPTH.drl]
2026-11-05 ケース: PCB 版の Fusion スクリプト（ガーバーの外形・穴のスケッチ、底・ふた・円形のトラックパッドリング）
    旧ケース（Top_new.stl）の寸法でトラックパッドの出っ張りを挟み、PCB の取り付け穴で
    底とふたをとめる。preview.py で同じ手順を manifold3d で実行し、STL・プレビュー・干渉を確かめる。
    Claude-Session: https://claude.ai/code/session_01Xb6JhmRoCXiQV7q1MXdiZ5
    [Bottom.stl, Cover.stl, TrackpadRing.stl]
2026-11-05 引き継ぎメモ: PCB 版のケースをローカル（Fusion MCP）で続けるためのメモ
    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
2026-11-05 ケース: Fusion で組み立てを確認し、MCP 経由で作り直すスクリプトを追加
    クラウドでは Fusion で一度も動かせていなかった。Fusion 内蔵の MCP サーバーから
    build() を実行し、エラーなしで作れること、manifold3d の版と体積が合うことを確かめた。
    パラメータを直すたびに UI からスクリプトを追加し直さなくて済むよう、ターミナルから
    作り直せるようにした。
2026-11-05 ケース: 干渉がないのは仮の箱の置き方のためだと注記、ドキュメント名の判定をスクリプトに合わせる
    FFC 変換基板の仮の箱は gen_models.py と違い、持ち上げてコネクタを省いているので、
    干渉チェックが通っても高さが収まるとは言えない。持ち主が誤って安心しないよう書いておく。
