yuzukq/hikyaku/docs/hardware/image/universal.png

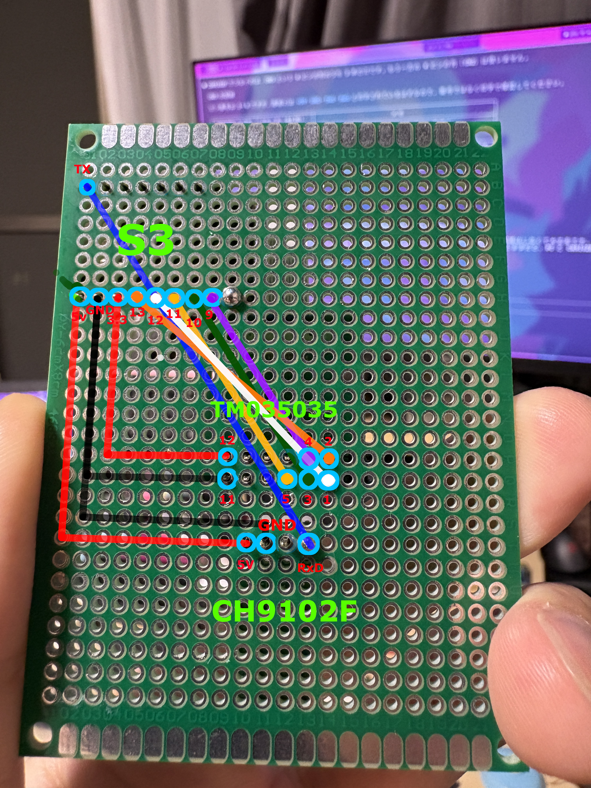
docs/hardware/image/universal.png
